XuanqinYu/eegDevice_DTU/README.md

# eegDevice_DTU

Codes contains Python script to use, and codes in Arduino or ESP-IDF for developing.

Design files contains schematic design and PCB design in KiCAD. And the simulation circuit is done in Ti-Tina.

Manual introduces how to use the script to visualize data and develop the device.
