XuanqinYu/eegDevice_DTU/Design Files/[Tina-TI] Simulation circuit/readme.TXT

This the amplification and filtering circuit for 4-channel EEG device. Including
	40 dB IA,
	0.5 Hz LPF,
	70 Hz HPF,
	40 dB amplifier,
	50 Hz Notch filter,
	2/VCC DC offset circuit,
	2 v/v AC amplifier
