XuanqinYu/eegDevice_DTU/Design Files/[KiCAD] EEG_single-channel_device/eeg_diy.kicad_pcb

## KiCad design Design Files/[KiCAD] EEG_single-channel_device/eeg_diy.kicad_pcb (2025-04-14)

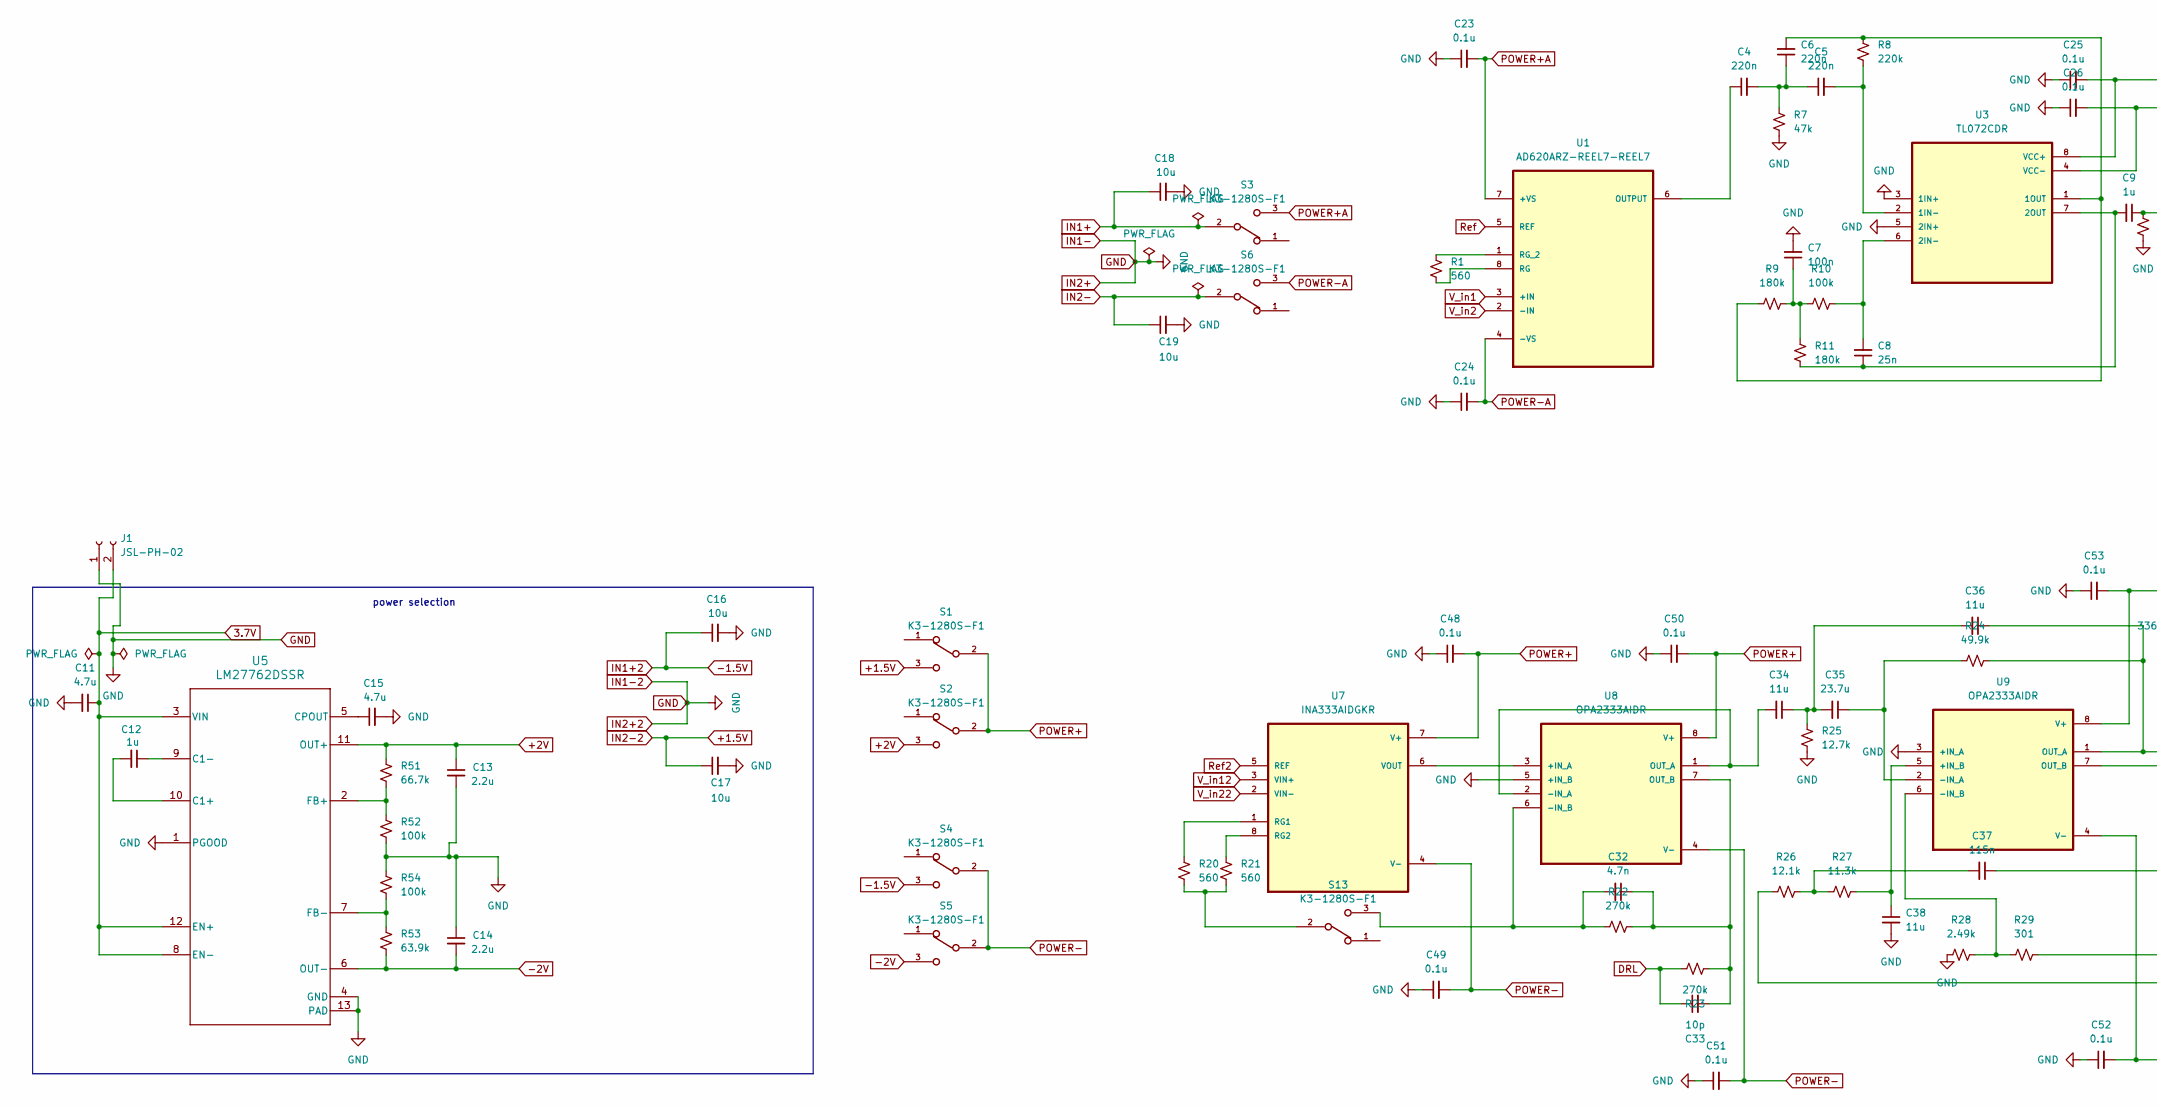
[picture p68: schematic eeg_diy.kicad_sch, part in row 1, column 1]

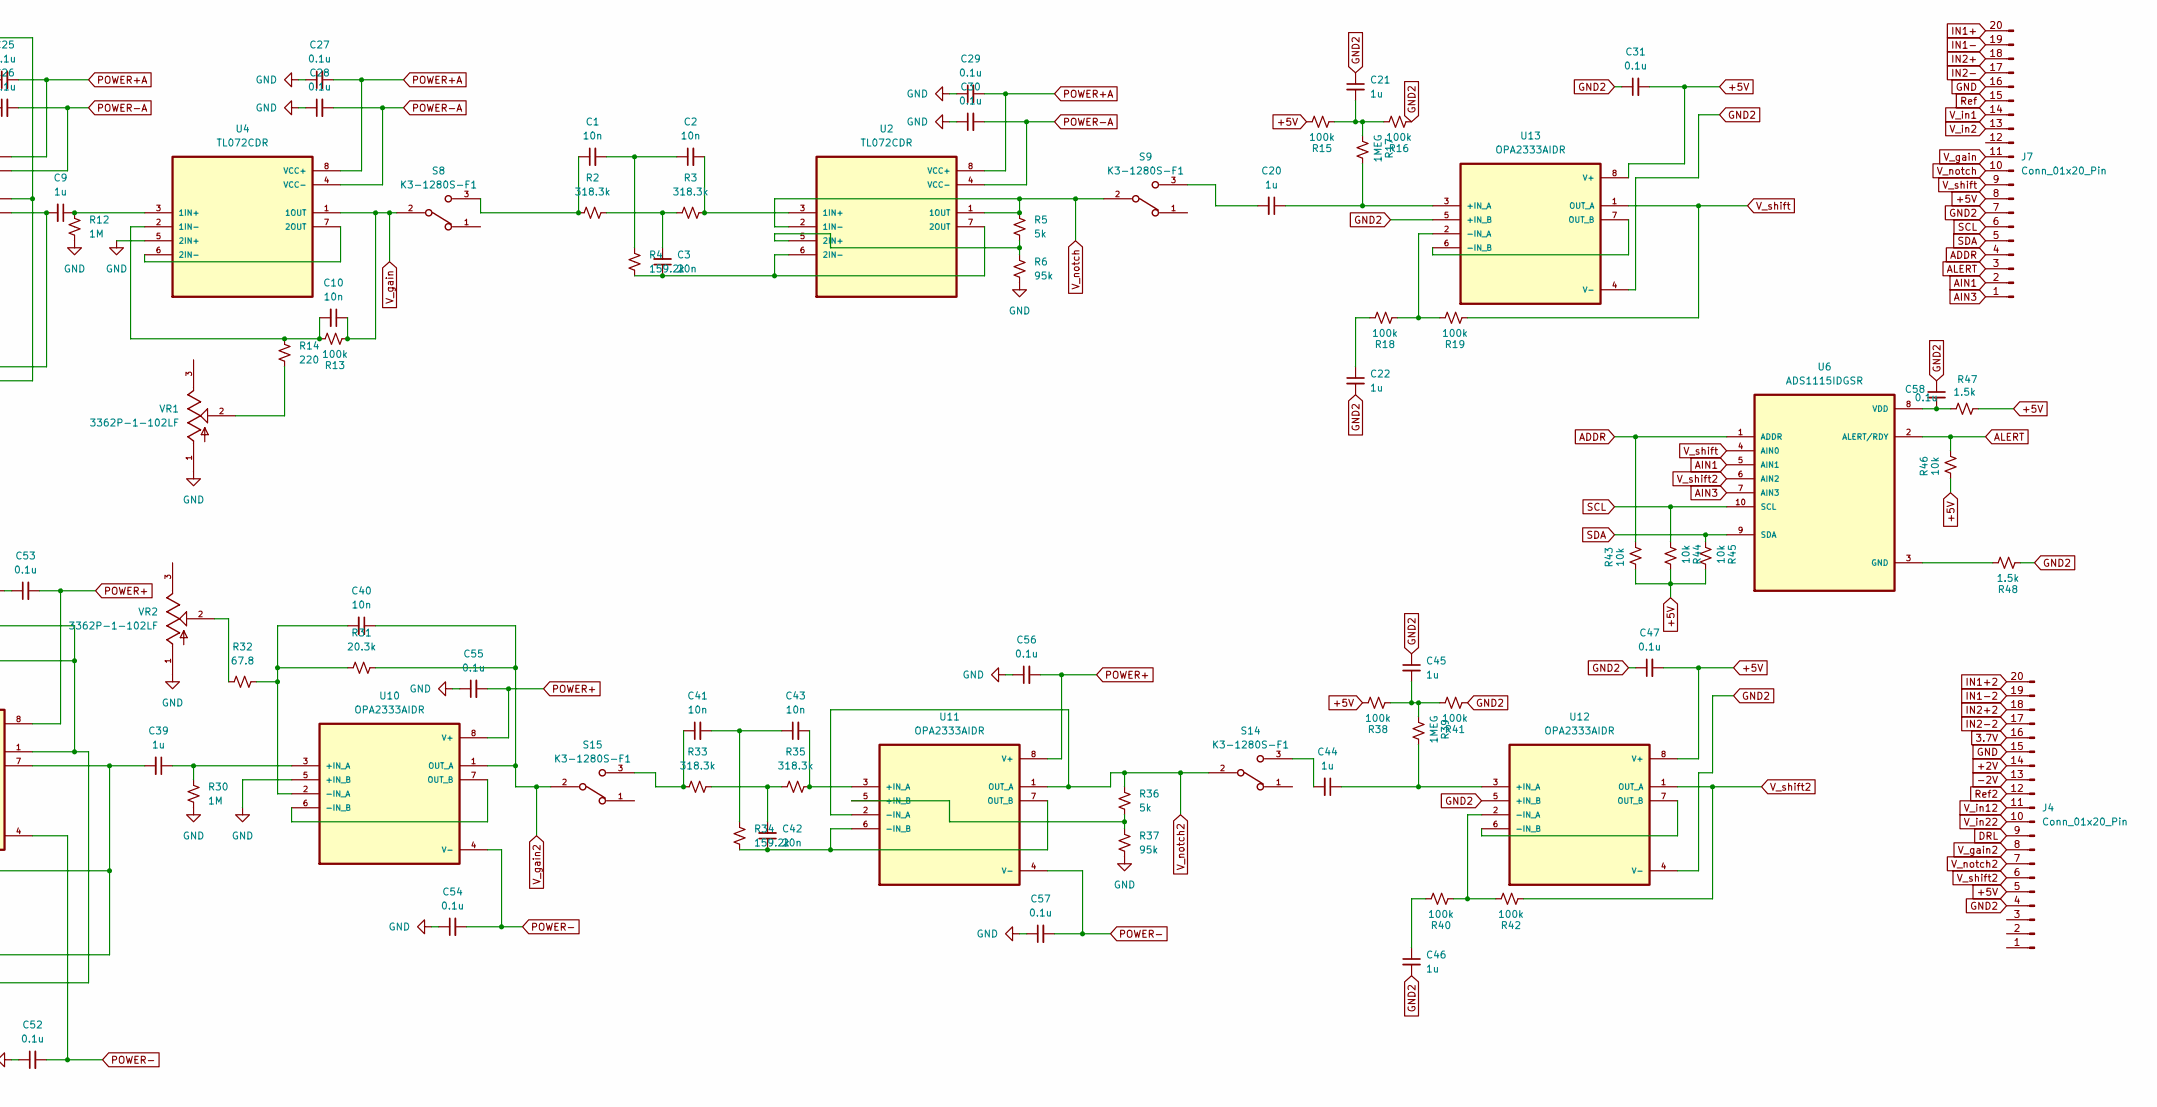
[picture p69: schematic eeg_diy.kicad_sch, part in row 1, column 2]

Parts:
C1, C2, C10, C40, C41, C43: 10n; C_0805_2012Metric
C3, C42: 20n; C_0805_2012Metric
C4, C5, C6: 220n; C_0805_2012Metric
C7: 100n; C_0805_2012Metric
C8: 25n; C_0805_2012Metric
C9, C12, C20, C21, C22, C39, C44, C45, C46: 1u; C_0805_2012Metric
C11, C15: 4.7u; C_0805_2012Metric
C13, C14: 2.2u; C_0603_1608Metric
C16, C17, C18, C19: 10u; C_0805_2012Metric
C23, C24, C25, C26, C27, C28, C29, C30, C31, C47, C48, C49, C50, C51, C52, C53, C54, C55, C56, C57, C58: 0.1u; C_0805_2012Metric
C32: 4.7n; C_0805_2012Metric
C33: 10p; C_0603_1608Metric
C34, C36, C38: 11u; C_0805_2012Metric
C35: 23.7u; C_0805_2012Metric
C37: 115n; C_0805_2012Metric
J1: JSL-PH-02; JST_PH_B2B-PH-K_1x02_P2.00mm_Vertical
J4, J7: Conn_01x20_Pin; PinSocket_1x20_P2.54mm_Vertical
R1, R20, R21: 560; R_0805_2012Metric
R2, R3, R33, R35: 318.3k; R_0603_1608Metric
R4, R34: 159.2k; R_0603_1608Metric
R5, R36: 5k; R_0603_1608Metric
R6, R37: 95k; R_0402_1005Metric
R7: 47k; R_0805_2012Metric
R8: 220k; R_0805_2012Metric
R9, R11: 180k; R_0805_2012Metric
R10, R13, R15, R16, R18, R19, R38, R40, R41, R42, R52, R54: 100k; R_0603_1608Metric
R12, R30: 1M; R_0805_2012Metric
R14: 220; R_0805_2012Metric
R17, R39: 1MEG; R_0805_2012Metric
R22, R23: 270k; R_0805_2012Metric
R24: 49.9k; R_0805_2012Metric
R25: 12.7k; R_0805_2012Metric
R26: 12.1k; R_0805_2012Metric
R27: 11.3k; R_0805_2012Metric
R28: 2.49k; R_0805_2012Metric
R29: 301; R_0805_2012Metric
R31: 20.3k; R_0805_2012Metric
R32: 67.8; R_0805_2012Metric
R43, R44, R45, R46: 10k; R_0805_2012Metric
R47, R48: 1.5k; R_0805_2012Metric
R51: 66.7k; R_0805_2012Metric
R53: 63.9k; R_0603_1608Metric
S1, S2, S3, S4, S5, S6, S8, S9, S13, S14, S15: K3-1280S-F1; SW_JS102011SAQN
U1: AD620ARZ-REEL7-REEL7; SOIC127P599X175-8N; MPN AD620ARZ-REEL7-REEL7
U2, U3, U4: TL072CDR; SOIC127P599X175-8N
U5: LM27762DSSR; DSS0012B
U6: ADS1115IDGSR; SOP50P490X110-10N
U7: INA333AIDGKR; SOP65P490X110-8N
U8, U9, U10, U11, U12, U13: OPA2333AIDR; SOIC127P599X175-8N
VR1, VR2: 3362P-1-102LF; TRIM_3362P-1-102LF; PARTREV 08/26/10

Connections:
3.7V: C11.1, J1.2, J4.16, U5.3 (VIN), U5.8 (EN-), U5.12 (EN+)
+1.5V: C17.1, J4.17, S1.3
+2V: C13.1, J4.14, R51.2, S2.3, U5.11 (OUT+)
+5V: C31.2, C47.2, J4.5, J7.8, R15.1, R38.1, R43.2, R44.1, R45.1, R46.2, R47.2, U12.8 (V+), U13.8 (V+)
-1.5V: C16.1, J4.20, S4.3
-2V: C14.2, J4.13, R53.1, S5.3, U5.6 (OUT-)
ADDR: J7.4, R43.1, U6.1 (ADDR)
AIN1: J7.2, U6.5 (AIN1)
AIN3: J7.1, U6.7 (AIN3)
ALERT: J7.3, R46.1, U6.2 (ALERT/RDY)
DRL: C33.1, J4.9, R23.2
GND: C7.2, C11.2, C13.2, C14.1, C15.2, C16.2, C17.2, C18.2, C19.2, C23.1, C24.1, C25.1, C26.1, C27.1, C28.1, C29.1, C30.1, C38.2, C48.1, C49.1, C50.1, C51.1, C52.1, C53.1, C54.1, C55.1, C56.1, C57.1, J1.1, J4.15, J4.18, J4.19, J7.16, J7.18, J7.19, R6.1, R7.1, R12.2, R25.1, R28.2, R30.2, R37.1, R52.1, R54.2, U3.3 (1IN+), U3.5 (2IN+), U4.5 (2IN+), U5.1 (PGOOD), U5.4 (GND), U5.13 (PAD), U8.5 (+IN_B), U9.3 (+IN_A), U10.5 (+IN_B), VR1.1, VR2.1
GND2: C21.1, C22.2, C31.1, C45.1, C46.2, C47.1, C58.1, J4.4, J7.7, R16.2, R41.2, R48.2, U12.4 (V-), U12.5 (+IN_B), U13.4 (V-), U13.5 (+IN_B)
IN1+: C18.1, J7.20, S3.2
IN2-: C19.1, J7.17, S6.2
unnamed: C1.1, R2.1, S8.3
unnamed: C1.2, C2.1, R4.2
unnamed: C3.2, R2.2, R3.1
unnamed: C4.2, C5.1, C6.1, R7.2
unnamed: C7.1, R9.1, R10.2, R11.1
unnamed: C20.2, S9.3
unnamed: C21.2, R15.2, R16.1, R17.2
unnamed: C22.1, R18.1
unnamed: C34.1, C35.2, C36.2, R25.2
unnamed: C37.2, R26.1, R27.2
unnamed: C41.1, R33.1, S15.3
unnamed: C41.2, C43.1, R34.2
unnamed: C42.2, R33.2, R35.1
unnamed: C44.2, S14.3
unnamed: C45.2, R38.2, R39.2, R41.1
unnamed: C46.1, R40.1
unnamed: R14.2, VR1.2
unnamed: R20.2, R21.2, S13.2
unnamed: R32.1, VR2.2
unnamed: C4.1, U1.6 (OUTPUT)
unnamed: R1.2, U1.8 (RG)
unnamed: R1.1, U1.1 (RG_2)
unnamed: C2.2, R3.2, U2.3 (1IN+)
unnamed: R5.1, R6.2, U2.5 (2IN+)
unnamed: C3.1, R4.1, U2.6 (2IN-), U2.7 (2OUT)
unnamed: C5.2, R8.1, U3.2 (1IN-)
unnamed: C6.2, R8.2, R9.2, U3.1 (1OUT)
unnamed: C8.2, R10.1, U3.6 (2IN-)
unnamed: C8.1, C9.2, R11.2, U3.7 (2OUT)
unnamed: C9.1, R12.1, U4.3 (1IN+)
unnamed: C10.2, R13.1, R14.1, U4.2 (1IN-)
unnamed: U4.6 (2IN-), U4.7 (2OUT)
unnamed: C12.2, U5.10 (C1+)
unnamed: C12.1, U5.9 (C1-)
unnamed: C15.1, U5.5 (CPOUT)
unnamed: R51.1, R52.2, U5.2 (FB+)
unnamed: R53.2, R54.1, U5.7 (FB-)
unnamed: R48.1, U6.3 (GND)
unnamed: C58.2, R47.1, U6.8 (VDD)
unnamed: R20.1, U7.1 (RG1)
unnamed: R21.1, U7.8 (RG2)
unnamed: U7.6 (VOUT), U8.3 (+IN_A)
unnamed: C34.2, U8.1 (OUT_A), U8.2 (-IN_A)
unnamed: C32.2, R22.1, S13.3, U8.6 (-IN_B)
unnamed: C32.1, C33.2, R22.2, R23.1, U8.7 (OUT_B)
unnamed: C38.1, R27.1, U9.5 (+IN_B)
unnamed: C35.1, R24.1, U9.2 (-IN_A)
unnamed: R28.1, R29.2, U9.6 (-IN_B)
unnamed: C36.1, R24.2, R26.2, U9.1 (OUT_A)
unnamed: C37.1, C39.2, R29.1, U9.7 (OUT_B)
unnamed: C39.1, R30.1, U10.3 (+IN_A)
unnamed: C40.2, R31.1, R32.2, U10.2 (-IN_A)
unnamed: U10.6 (-IN_B), U10.7 (OUT_B)
unnamed: C43.2, R35.2, U11.3 (+IN_A)
unnamed: R36.1, R37.2, U11.5 (+IN_B)
unnamed: C42.1, R34.1, U11.6 (-IN_B), U11.7 (OUT_B)
unnamed: C44.1, R39.1, U12.3 (+IN_A)
unnamed: R40.2, R42.1, U12.2 (-IN_A)
unnamed: U12.6 (-IN_B), U12.7 (OUT_B)
unnamed: C20.1, R17.1, U13.3 (+IN_A)
unnamed: R18.2, R19.1, U13.2 (-IN_A)
unnamed: U13.6 (-IN_B), U13.7 (OUT_B)
POWER+: C48.2, C50.2, C53.2, C55.2, C56.2, S1.2, S2.2, U7.7 (V+), U8.8 (V+), U9.8 (V+), U10.8 (V+), U11.8 (V+)
POWER+A: C23.2, C25.2, C27.2, C29.2, S3.3, U1.7 (+VS), U2.8 (VCC+), U3.8 (VCC+), U4.8 (VCC+)
POWER-: C49.2, C51.2, C52.2, C54.2, C57.2, S4.2, S5.2, U7.4 (V-), U8.4 (V-), U9.4 (V-), U10.4 (V-), U11.4 (V-)
POWER-A: C24.2, C26.2, C28.2, C30.2, S6.3, U1.4 (-VS), U2.4 (VCC-), U3.4 (VCC-), U4.4 (VCC-)
Ref: J7.15, U1.5 (REF)
Ref2: J4.12, U7.5 (REF)
SCL: J7.6, R44.2, U6.10 (SCL)
SDA: J7.5, R45.2, U6.9 (SDA)
V_gain: C10.1, J7.11, R13.2, S8.2, U4.1 (1OUT)
V_gain2: C40.1, J4.8, R31.2, S15.2, U10.1 (OUT_A)
V_in1: J7.14, U1.3 (+IN)
V_in2: J7.13, U1.2 (-IN)
V_in12: J4.11, U7.3 (VIN+)
V_in22: J4.10, U7.2 (VIN-)
V_notch: J7.10, R5.2, S9.2, U2.1 (1OUT), U2.2 (1IN-)
V_notch2: J4.7, R36.2, S14.2, U11.1 (OUT_A), U11.2 (-IN_A)
V_shift: J7.9, R19.2, U6.4 (AIN0), U13.1 (OUT_A)
V_shift2: J4.6, R42.2, U6.6 (AIN2), U12.1 (OUT_A)

Notes on the sheet:
power selection

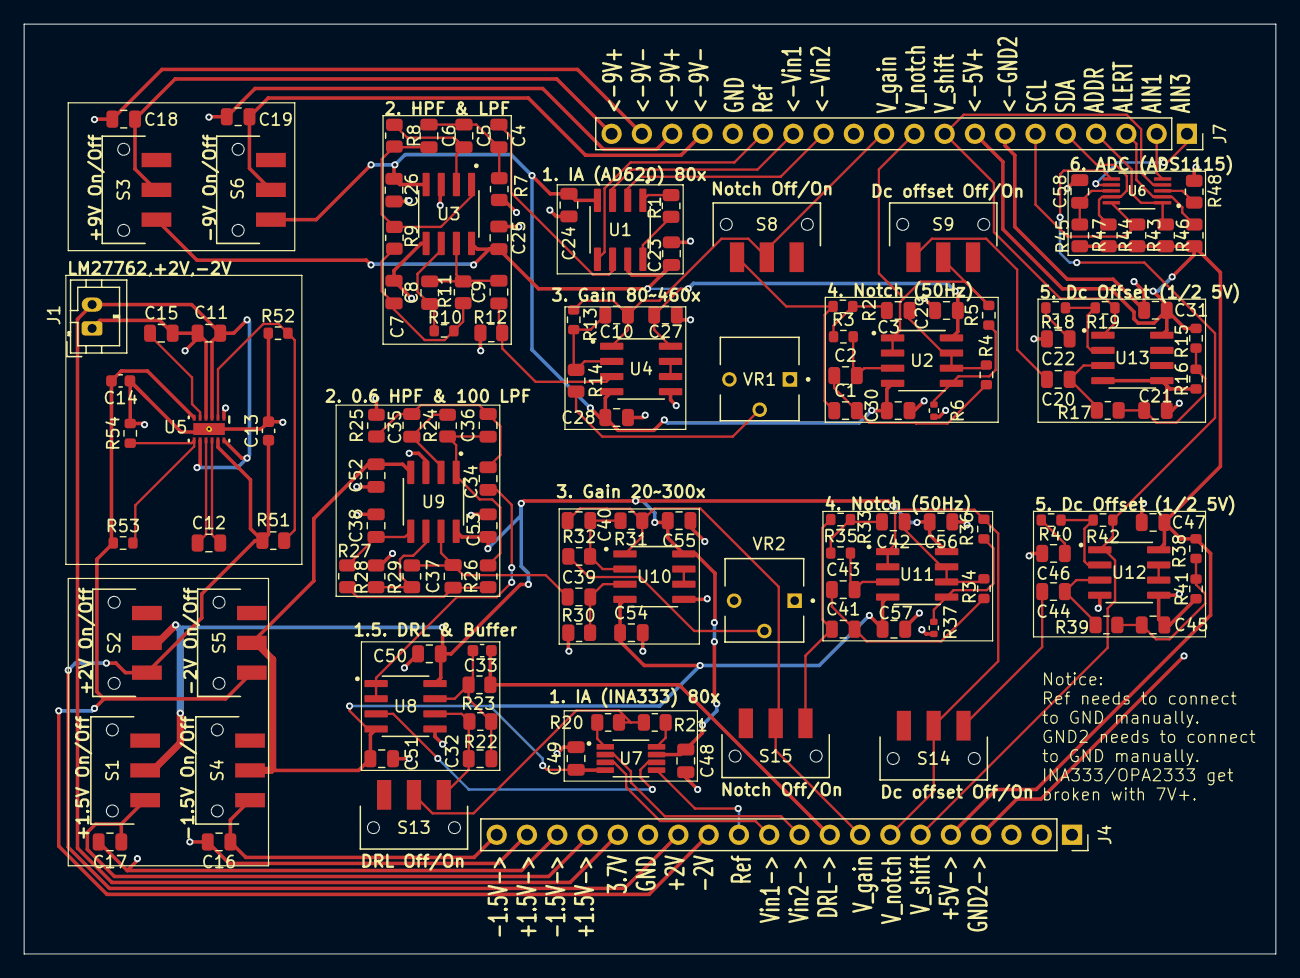
[picture p70: board eeg_diy.kicad_pcb from above]

Board: 2 copper layers, 105.0 x 78.0 mm, 139 parts (0 on the bottom side), 95 nets.
