XuanqinYu/eegDevice_DTU/Design Files/[KiCAD] EEG_4-channel_device/eeg_4-channel_final.kicad_pcb

## KiCad design Design Files/[KiCAD] EEG_4-channel_device/eeg_4-channel_final.kicad_pcb (2025-03-30)

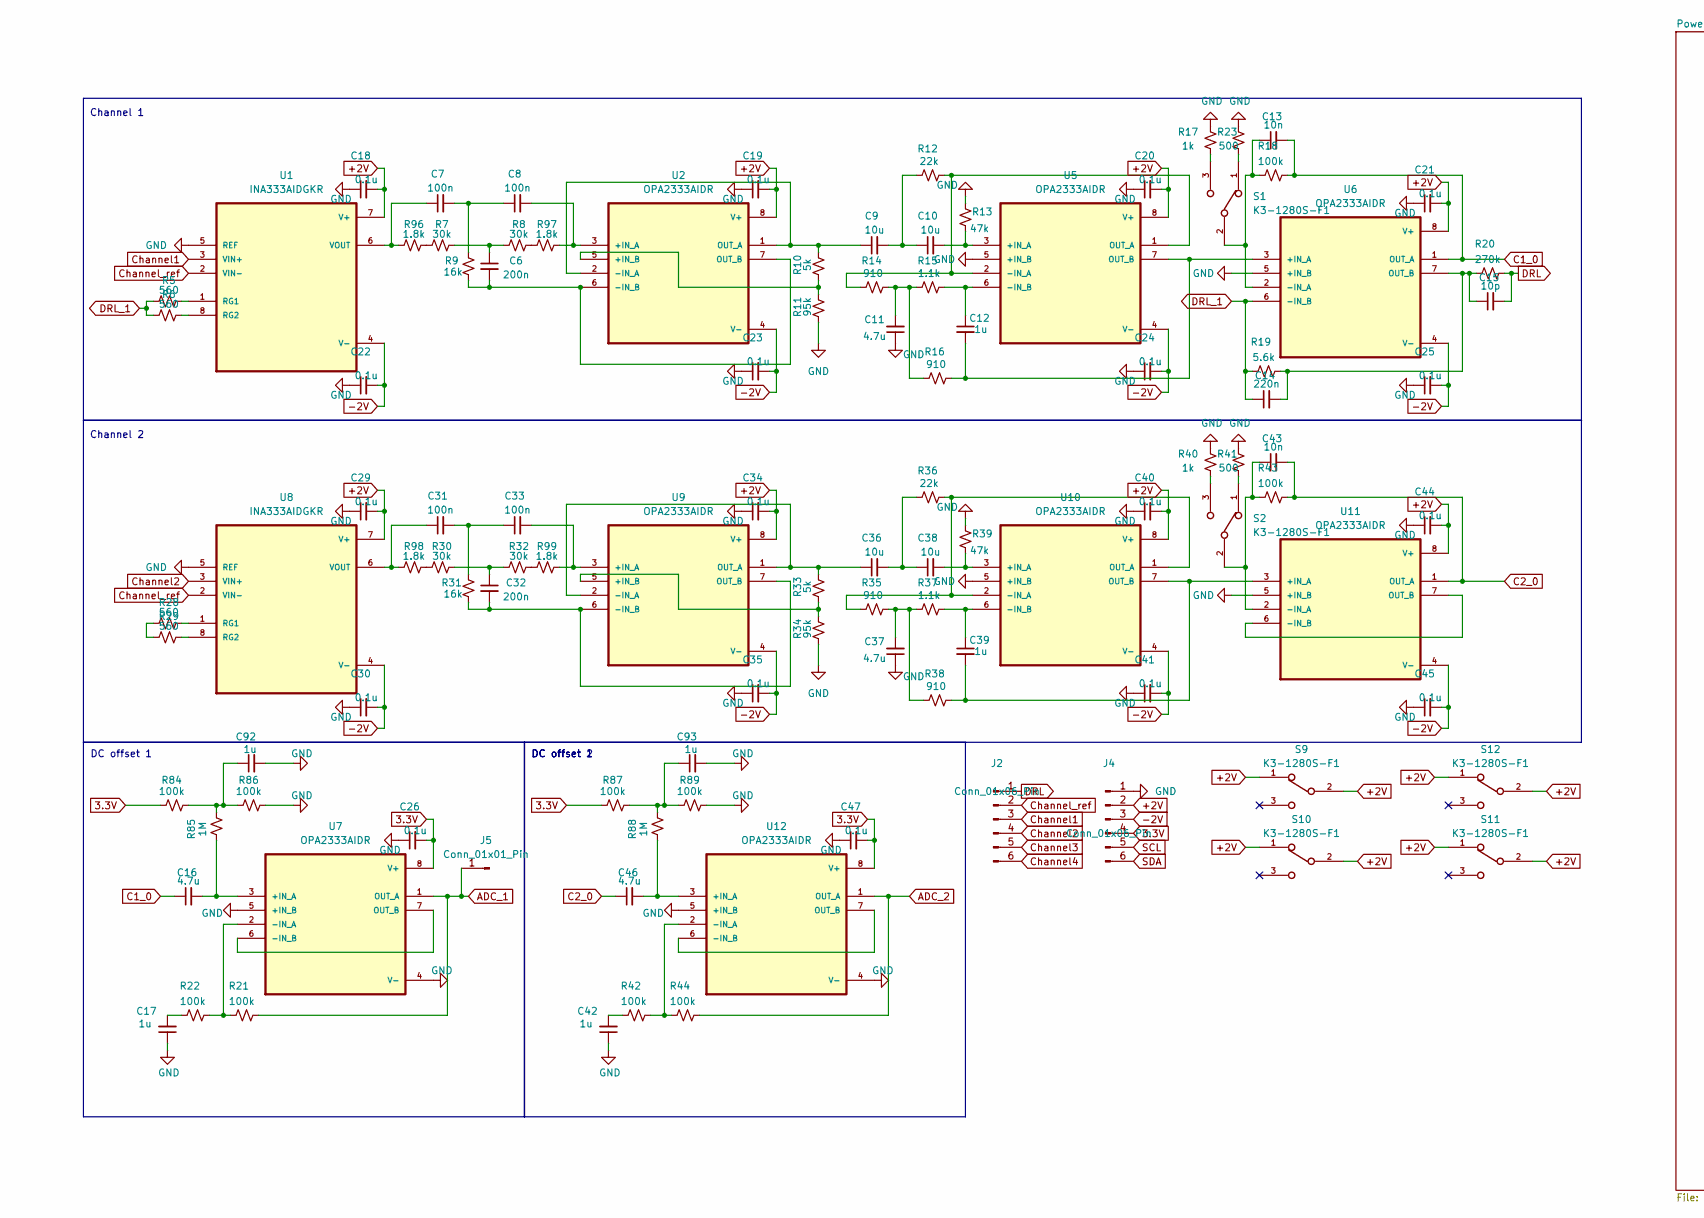
[picture p71: schematic eeg_4-channel_final.kicad_sch, part in row 1, column 1]

Parts:
C6, C32: 200n; C_0805_2012Metric
C7, C8, C31, C33: 100n; C_0805_2012Metric
C9, C10, C36, C38: 10u; C_0805_2012Metric
C11, C16, C37, C46: 4.7u; C_0805_2012Metric
C12, C17, C39, C42, C92, C93: 1u; C_0805_2012Metric
C13, C43: 10n; C_0805_2012Metric
C14: 220n; C_0805_2012Metric
C15: 10p; C_0603_1608Metric
C18, C19, C20, C21, C22, C23, C24, C25, C26, C29, C30, C34, C35, C40, C41, C44, C45, C47: 0.1u; C_0805_2012Metric
J2, J4: Conn_01x06_Pin; PinHeader_1x06_P2.54mm_Vertical
J5: Conn_01x01_Pin; PinHeader_1x01_P2.54mm_Vertical
R5, R6, R28, R29: 560; R_0805_2012Metric
R7, R8, R30, R32: 30k; R_0805_2012Metric
R9, R31: 16k; R_0805_2012Metric
R10, R33: 5k; R_0805_2012Metric
R11, R34: 95k; R_0603_1608Metric
R12, R36: 22k; R_0805_2012Metric
R13, R39: 47k; R_0805_2012Metric
R14, R16, R35, R38: 910; R_0805_2012Metric
R15, R37: 1.1k; R_0603_1608Metric
R17, R40: 1k; R_0805_2012Metric
R18, R21, R22, R42, R43, R44, R84, R86, R87, R89: 100k; R_0603_1608Metric
R19: 5.6k; R_0805_2012Metric
R20: 270k; R_0805_2012Metric
R23, R41: 500; R_0805_2012Metric
R85, R88: 1M; R_0805_2012Metric
R96, R97, R98, R99: 1.8k; R_0805_2012Metric
S1, S2, S9, S10, S11, S12: K3-1280S-F1; SW_JS102011SAQN
U1, U8: INA333AIDGKR; SOP65P490X110-8N
U2, U5, U6, U7, U9, U10, U11, U12: OPA2333AIDR; SOIC127P599X175-8N

Connections:
3.3V: C26.2, C47.2, J4.4, R84.1, R87.1, U7.8 (V+), U12.8 (V+); also elsewhere on the board
+2V: C18.2, C19.2, C20.2, C21.2, C29.2, C34.2, C40.2, C44.2, J4.2, S9.1, S9.2, S10.1, S10.2, S11.1, S11.2, S12.1, S12.2, U1.7 (V+), U2.8 (V+), U5.8 (V+), U6.8 (V+), U8.7 (V+), U9.8 (V+), U10.8 (V+), U11.8 (V+); also elsewhere on the board
-2V: C22.2, C23.2, C24.2, C25.2, C30.2, C35.2, C41.2, C45.2, J4.3, U1.4 (V-), U2.4 (V-), U5.4 (V-), U6.4 (V-), U8.4 (V-), U9.4 (V-), U10.4 (V-), U11.4 (V-); also elsewhere on the board
ADC_1: J5.1, R21.2, U7.1 (OUT_A); also elsewhere on the board
ADC_2: R44.2, U12.1 (OUT_A); also elsewhere on the board
C1_0: C13.2, C16.1, R18.2, U6.1 (OUT_A)
C2_0: C43.2, C46.1, R43.2, U11.1 (OUT_A)
Channel1: J2.3, U1.3 (VIN+)
Channel2: J2.4, U8.3 (VIN+)
Channel3: J2.5; also elsewhere on the board
Channel4: J2.6; also elsewhere on the board
Channel_ref: J2.2, U1.2 (VIN-), U8.2 (VIN-); also elsewhere on the board
DRL: C15.2, J2.1, R20.2
DRL_1: C14.1, R5.2, R6.2, R19.1, U6.6 (-IN_B)
GND: C11.1, C17.1, C18.1, C19.1, C20.1, C21.1, C22.1, C23.1, C24.1, C25.1, C26.1, C29.1, C30.1, C34.1, C35.1, C37.1, C40.1, C41.1, C42.1, C44.1, C45.1, C47.1, C92.2, C93.2, J4.1, R11.2, R13.1, R17.1, R23.2, R34.2, R39.1, R40.1, R41.2, R86.2, R89.2, U1.5 (REF), U5.5 (+IN_B), U6.5 (+IN_B), U7.4 (V-), U7.5 (+IN_B), U8.5 (REF), U10.5 (+IN_B), U11.5 (+IN_B), U12.4 (V-), U12.5 (+IN_B); also elsewhere on the board
unnamed: C6.1, R7.1, R8.2
unnamed: C7.2, C8.1, R9.1
unnamed: C9.2, C10.1, R12.1
unnamed: C11.2, R14.2, R15.1, R16.1
unnamed: C17.2, R22.1
unnamed: C31.2, C33.1, R31.1
unnamed: C32.1, R30.1, R32.2
unnamed: C36.2, C38.1, R36.1
unnamed: C37.2, R35.2, R37.1, R38.1
unnamed: C42.2, R42.1
unnamed: C92.1, R84.2, R85.2, R86.1
unnamed: C93.1, R87.2, R88.2, R89.1
unnamed: R7.2, R96.1
unnamed: R8.1, R97.2
unnamed: R17.2, S1.3
unnamed: R23.1, S1.1
unnamed: R28.2, R29.2
unnamed: R30.2, R98.1
unnamed: R32.1, R99.2
unnamed: R40.2, S2.3
unnamed: R41.1, S2.1
unnamed: R5.1, U1.1 (RG1)
unnamed: R6.1, U1.8 (RG2)
unnamed: C7.1, R96.2, U1.6 (VOUT)
unnamed: C8.2, R97.1, U2.3 (+IN_A)
unnamed: R10.2, R11.1, U2.5 (+IN_B)
unnamed: C9.1, R10.1, U2.1 (OUT_A), U2.2 (-IN_A)
unnamed: C6.2, R9.2, U2.6 (-IN_B), U2.7 (OUT_B)
unnamed: C10.2, R13.2, U5.3 (+IN_A)
unnamed: R12.2, R14.1, U5.1 (OUT_A), U5.2 (-IN_A)
unnamed: C12.1, R15.2, U5.6 (-IN_B)
unnamed: C12.2, R16.2, U5.7 (OUT_B), U6.3 (+IN_A)
unnamed: C13.1, R18.1, S1.2, U6.2 (-IN_A)
unnamed: C14.2, C15.1, R19.2, R20.1, U6.7 (OUT_B)
unnamed: C16.2, R85.1, U7.3 (+IN_A)
unnamed: R21.1, R22.2, U7.2 (-IN_A)
unnamed: U7.6 (-IN_B), U7.7 (OUT_B)
unnamed: R28.1, U8.1 (RG1)
unnamed: R29.1, U8.8 (RG2)
unnamed: C31.1, R98.2, U8.6 (VOUT)
unnamed: C33.2, R99.1, U9.3 (+IN_A)
unnamed: R33.2, R34.1, U9.5 (+IN_B)
unnamed: C36.1, R33.1, U9.1 (OUT_A), U9.2 (-IN_A)
unnamed: C32.2, R31.2, U9.6 (-IN_B), U9.7 (OUT_B)
unnamed: C38.2, R39.2, U10.3 (+IN_A)
unnamed: R35.1, R36.2, U10.1 (OUT_A), U10.2 (-IN_A)
unnamed: C39.1, R37.2, U10.6 (-IN_B)
unnamed: C39.2, R38.2, U10.7 (OUT_B), U11.3 (+IN_A)
unnamed: C43.1, R43.1, S2.2, U11.2 (-IN_A)
unnamed: U11.6 (-IN_B), U11.7 (OUT_B)
unnamed: C46.2, R88.1, U12.3 (+IN_A)
unnamed: R42.2, R44.1, U12.2 (-IN_A)
unnamed: U12.6 (-IN_B), U12.7 (OUT_B)
SCL: J4.5; also elsewhere on the board
SDA: J4.6; also elsewhere on the board

Notes on the sheet:
Channel 1
DC offset 2
DC offset 1
Channel 2

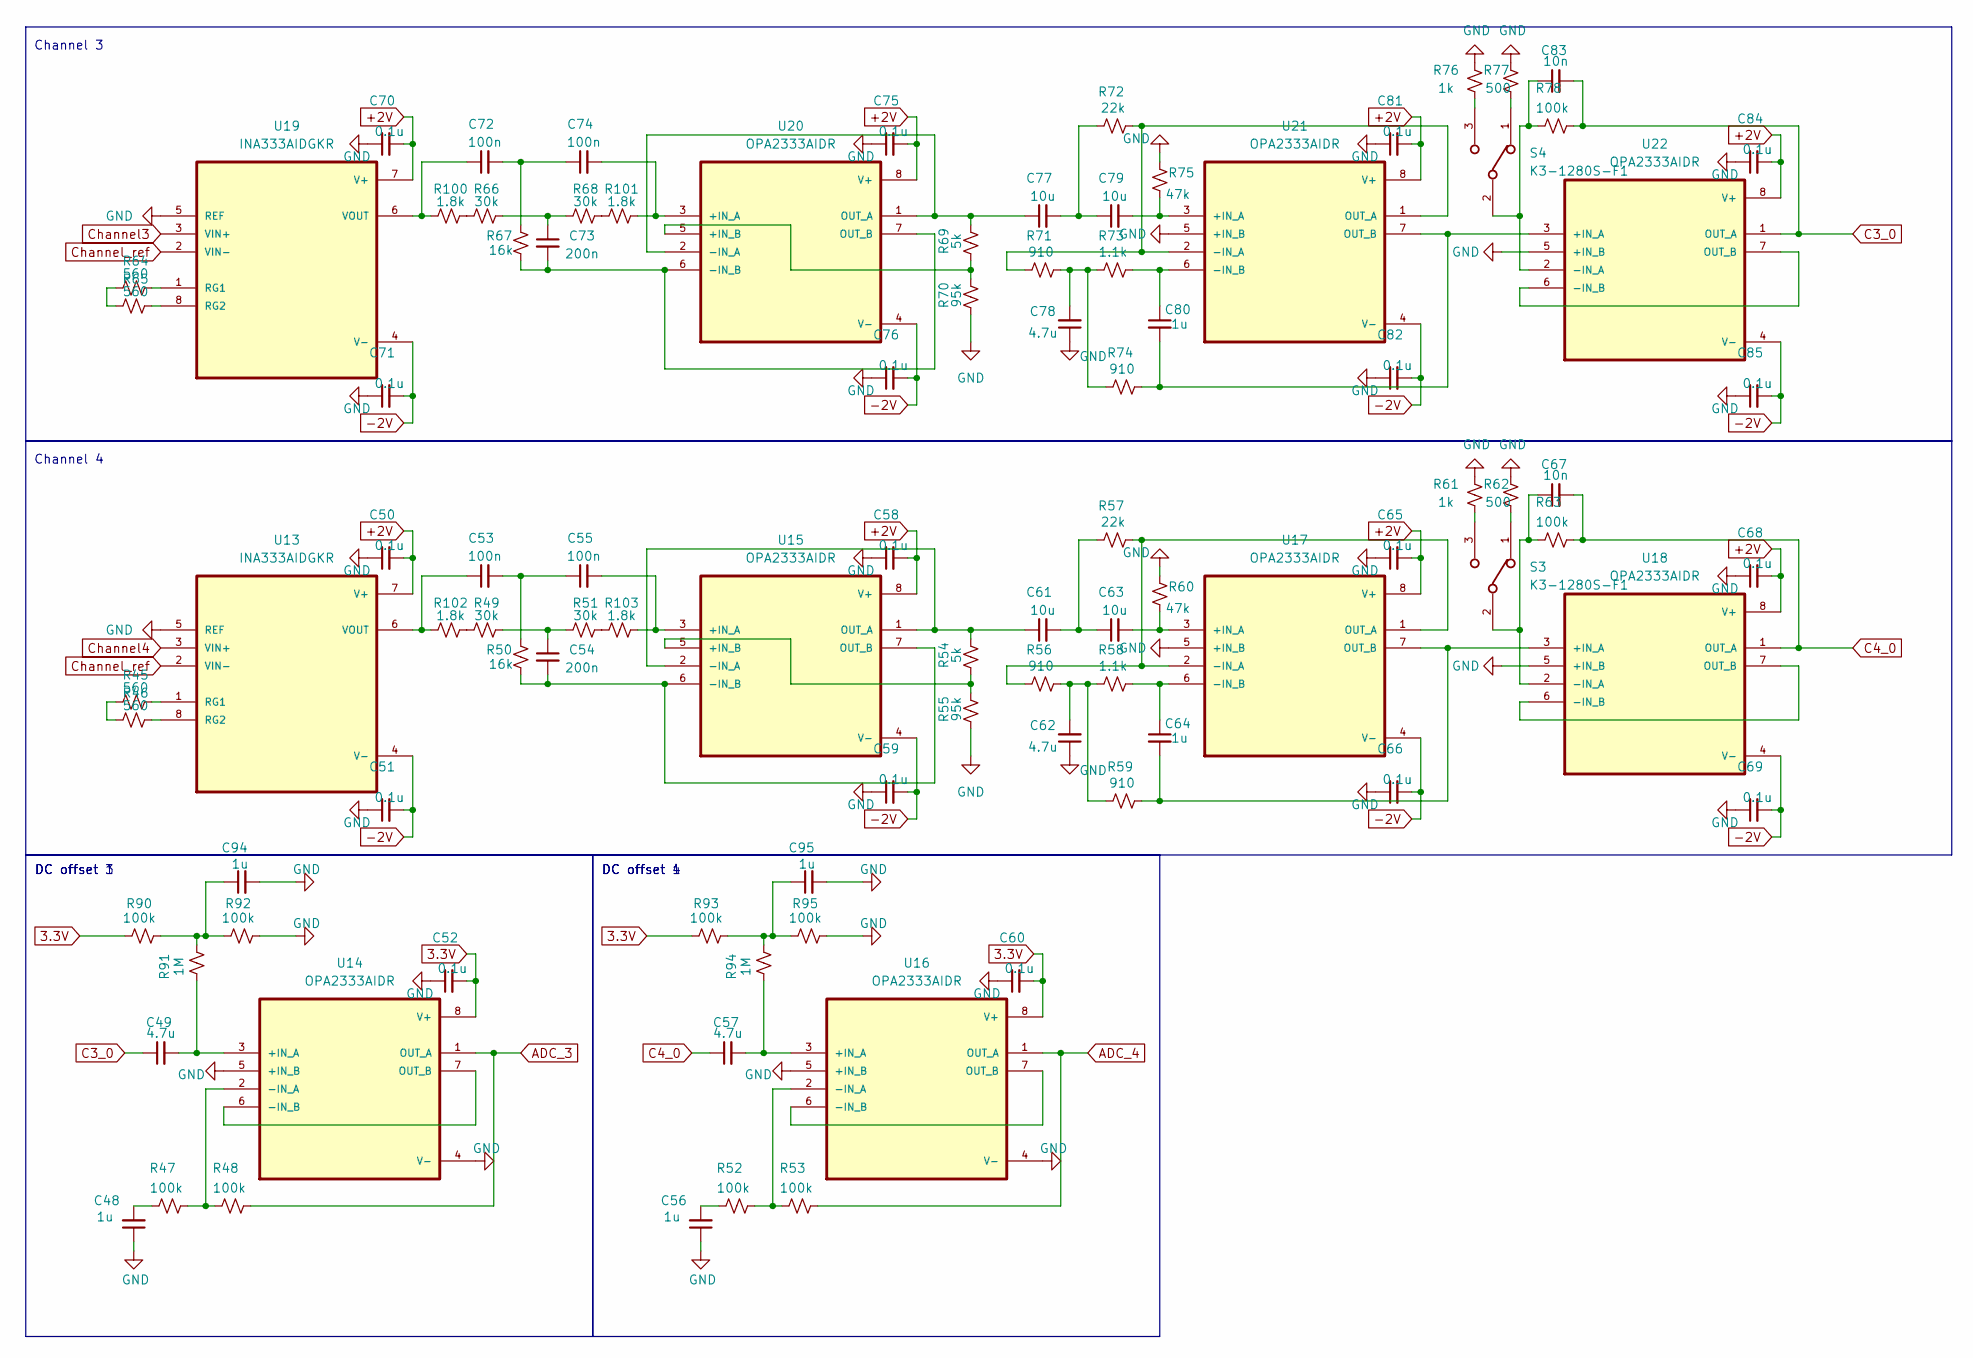
[picture p72: schematic Channel3_4.kicad_sch]

Parts:
C48, C56, C64, C80, C94, C95: 1u; C_0805_2012Metric
C49, C57, C62, C78: 4.7u; C_0805_2012Metric
C50, C51, C52, C58, C59, C60, C65, C66, C68, C69, C70, C71, C75, C76, C81, C82, C84, C85: 0.1u; C_0805_2012Metric
C53, C55, C72, C74: 100n; C_0805_2012Metric
C54, C73: 200n; C_0805_2012Metric
C61, C63, C77, C79: 10u; C_0805_2012Metric
C67, C83: 10n; C_0805_2012Metric
R45, R46, R64, R65: 560; R_0805_2012Metric
R47, R48, R52, R53, R63, R78, R90, R92, R93, R95: 100k; R_0603_1608Metric
R49, R51, R66, R68: 30k; R_0805_2012Metric
R50, R67: 16k; R_0805_2012Metric
R54, R69: 5k; R_0805_2012Metric
R55, R70: 95k; R_0603_1608Metric
R56, R59, R71, R74: 910; R_0805_2012Metric
R57, R72: 22k; R_0805_2012Metric
R58, R73: 1.1k; R_0603_1608Metric
R60, R75: 47k; R_0805_2012Metric
R61, R76: 1k; R_0805_2012Metric
R62, R77: 500; R_0805_2012Metric
R91, R94: 1M; R_0805_2012Metric
R100, R101, R102, R103: 1.8k; R_0805_2012Metric
S3, S4: K3-1280S-F1; SW_JS102011SAQN
U13, U19: INA333AIDGKR; SOP65P490X110-8N
U14, U15, U16, U17, U18, U20, U21, U22: OPA2333AIDR; SOIC127P599X175-8N

Connections:
3.3V: C52.2, C60.2, R90.1, R93.1, U14.8 (V+), U16.8 (V+); also elsewhere on the board
+2V: C50.2, C58.2, C65.2, C68.2, C70.2, C75.2, C81.2, C84.2, U13.7 (V+), U15.8 (V+), U17.8 (V+), U18.8 (V+), U19.7 (V+), U20.8 (V+), U21.8 (V+), U22.8 (V+); also elsewhere on the board
-2V: C51.2, C59.2, C66.2, C69.2, C71.2, C76.2, C82.2, C85.2, U13.4 (V-), U15.4 (V-), U17.4 (V-), U18.4 (V-), U19.4 (V-), U20.4 (V-), U21.4 (V-), U22.4 (V-); also elsewhere on the board
ADC_3: R48.2, U14.1 (OUT_A); also elsewhere on the board
ADC_4: R53.2, U16.1 (OUT_A); also elsewhere on the board
C3_0: C49.1, C83.2, R78.2, U22.1 (OUT_A)
C4_0: C57.1, C67.2, R63.2, U18.1 (OUT_A)
Channel3: U19.3 (VIN+); also elsewhere on the board
Channel4: U13.3 (VIN+); also elsewhere on the board
Channel_ref: U13.2 (VIN-), U19.2 (VIN-); also elsewhere on the board
GND: C48.1, C50.1, C51.1, C52.1, C56.1, C58.1, C59.1, C60.1, C62.1, C65.1, C66.1, C68.1, C69.1, C70.1, C71.1, C75.1, C76.1, C78.1, C81.1, C82.1, C84.1, C85.1, C94.2, C95.2, R55.2, R60.1, R61.1, R62.2, R70.2, R75.1, R76.1, R77.2, R92.2, R95.2, U13.5 (REF), U14.4 (V-), U14.5 (+IN_B), U16.4 (V-), U16.5 (+IN_B), U17.5 (+IN_B), U18.5 (+IN_B), U19.5 (REF), U21.5 (+IN_B), U22.5 (+IN_B); also elsewhere on the board
unnamed: C48.2, R47.1
unnamed: C53.2, C55.1, R50.1
unnamed: C54.1, R49.1, R51.2
unnamed: C56.2, R52.1
unnamed: C61.2, C63.1, R57.1
unnamed: C62.2, R56.2, R58.1, R59.1
unnamed: C72.2, C74.1, R67.1
unnamed: C73.1, R66.1, R68.2
unnamed: C77.2, C79.1, R72.1
unnamed: C78.2, R71.2, R73.1, R74.1
unnamed: C94.1, R90.2, R91.2, R92.1
unnamed: C95.1, R93.2, R94.2, R95.1
unnamed: R45.2, R46.2
unnamed: R61.2, S3.3
unnamed: R62.1, S3.1
unnamed: R64.2, R65.2
unnamed: R76.2, S4.3
unnamed: R77.1, S4.1
unnamed: R66.2, R100.1
unnamed: R68.1, R101.2
unnamed: R49.2, R102.1
unnamed: R51.1, R103.2
unnamed: R45.1, U13.1 (RG1)
unnamed: R46.1, U13.8 (RG2)
unnamed: C53.1, R102.2, U13.6 (VOUT)
unnamed: C49.2, R91.1, U14.3 (+IN_A)
unnamed: R47.2, R48.1, U14.2 (-IN_A)
unnamed: U14.6 (-IN_B), U14.7 (OUT_B)
unnamed: C55.2, R103.1, U15.3 (+IN_A)
unnamed: R54.2, R55.1, U15.5 (+IN_B)
unnamed: C61.1, R54.1, U15.1 (OUT_A), U15.2 (-IN_A)
unnamed: C54.2, R50.2, U15.6 (-IN_B), U15.7 (OUT_B)
unnamed: C57.2, R94.1, U16.3 (+IN_A)
unnamed: R52.2, R53.1, U16.2 (-IN_A)
unnamed: U16.6 (-IN_B), U16.7 (OUT_B)
unnamed: C63.2, R60.2, U17.3 (+IN_A)
unnamed: R56.1, R57.2, U17.1 (OUT_A), U17.2 (-IN_A)
unnamed: C64.1, R58.2, U17.6 (-IN_B)
unnamed: C64.2, R59.2, U17.7 (OUT_B), U18.3 (+IN_A)
unnamed: C67.1, R63.1, S3.2, U18.2 (-IN_A)
unnamed: U18.6 (-IN_B), U18.7 (OUT_B)
unnamed: R64.1, U19.1 (RG1)
unnamed: R65.1, U19.8 (RG2)
unnamed: C72.1, R100.2, U19.6 (VOUT)
unnamed: C74.2, R101.1, U20.3 (+IN_A)
unnamed: R69.2, R70.1, U20.5 (+IN_B)
unnamed: C77.1, R69.1, U20.1 (OUT_A), U20.2 (-IN_A)
unnamed: C73.2, R67.2, U20.6 (-IN_B), U20.7 (OUT_B)
unnamed: C79.2, R75.2, U21.3 (+IN_A)
unnamed: R71.1, R72.2, U21.1 (OUT_A), U21.2 (-IN_A)
unnamed: C80.1, R73.2, U21.6 (-IN_B)
unnamed: C80.2, R74.2, U21.7 (OUT_B), U22.3 (+IN_A)
unnamed: C83.1, R78.1, S4.2, U22.2 (-IN_A)
unnamed: U22.6 (-IN_B), U22.7 (OUT_B)

Notes on the sheet:
DC offset 3
DC offset 4
DC offset 1
Channel 3
Channel 4
