XuanqinYu/eegDevice_DTU/Design Files/[KiCAD] EEG_4-channel_device/eeg_4-channel_final.kicad_pcb

## KiCad design Design Files/[KiCAD] EEG_4-channel_device/eeg_4-channel_final.kicad_pcb (continued)

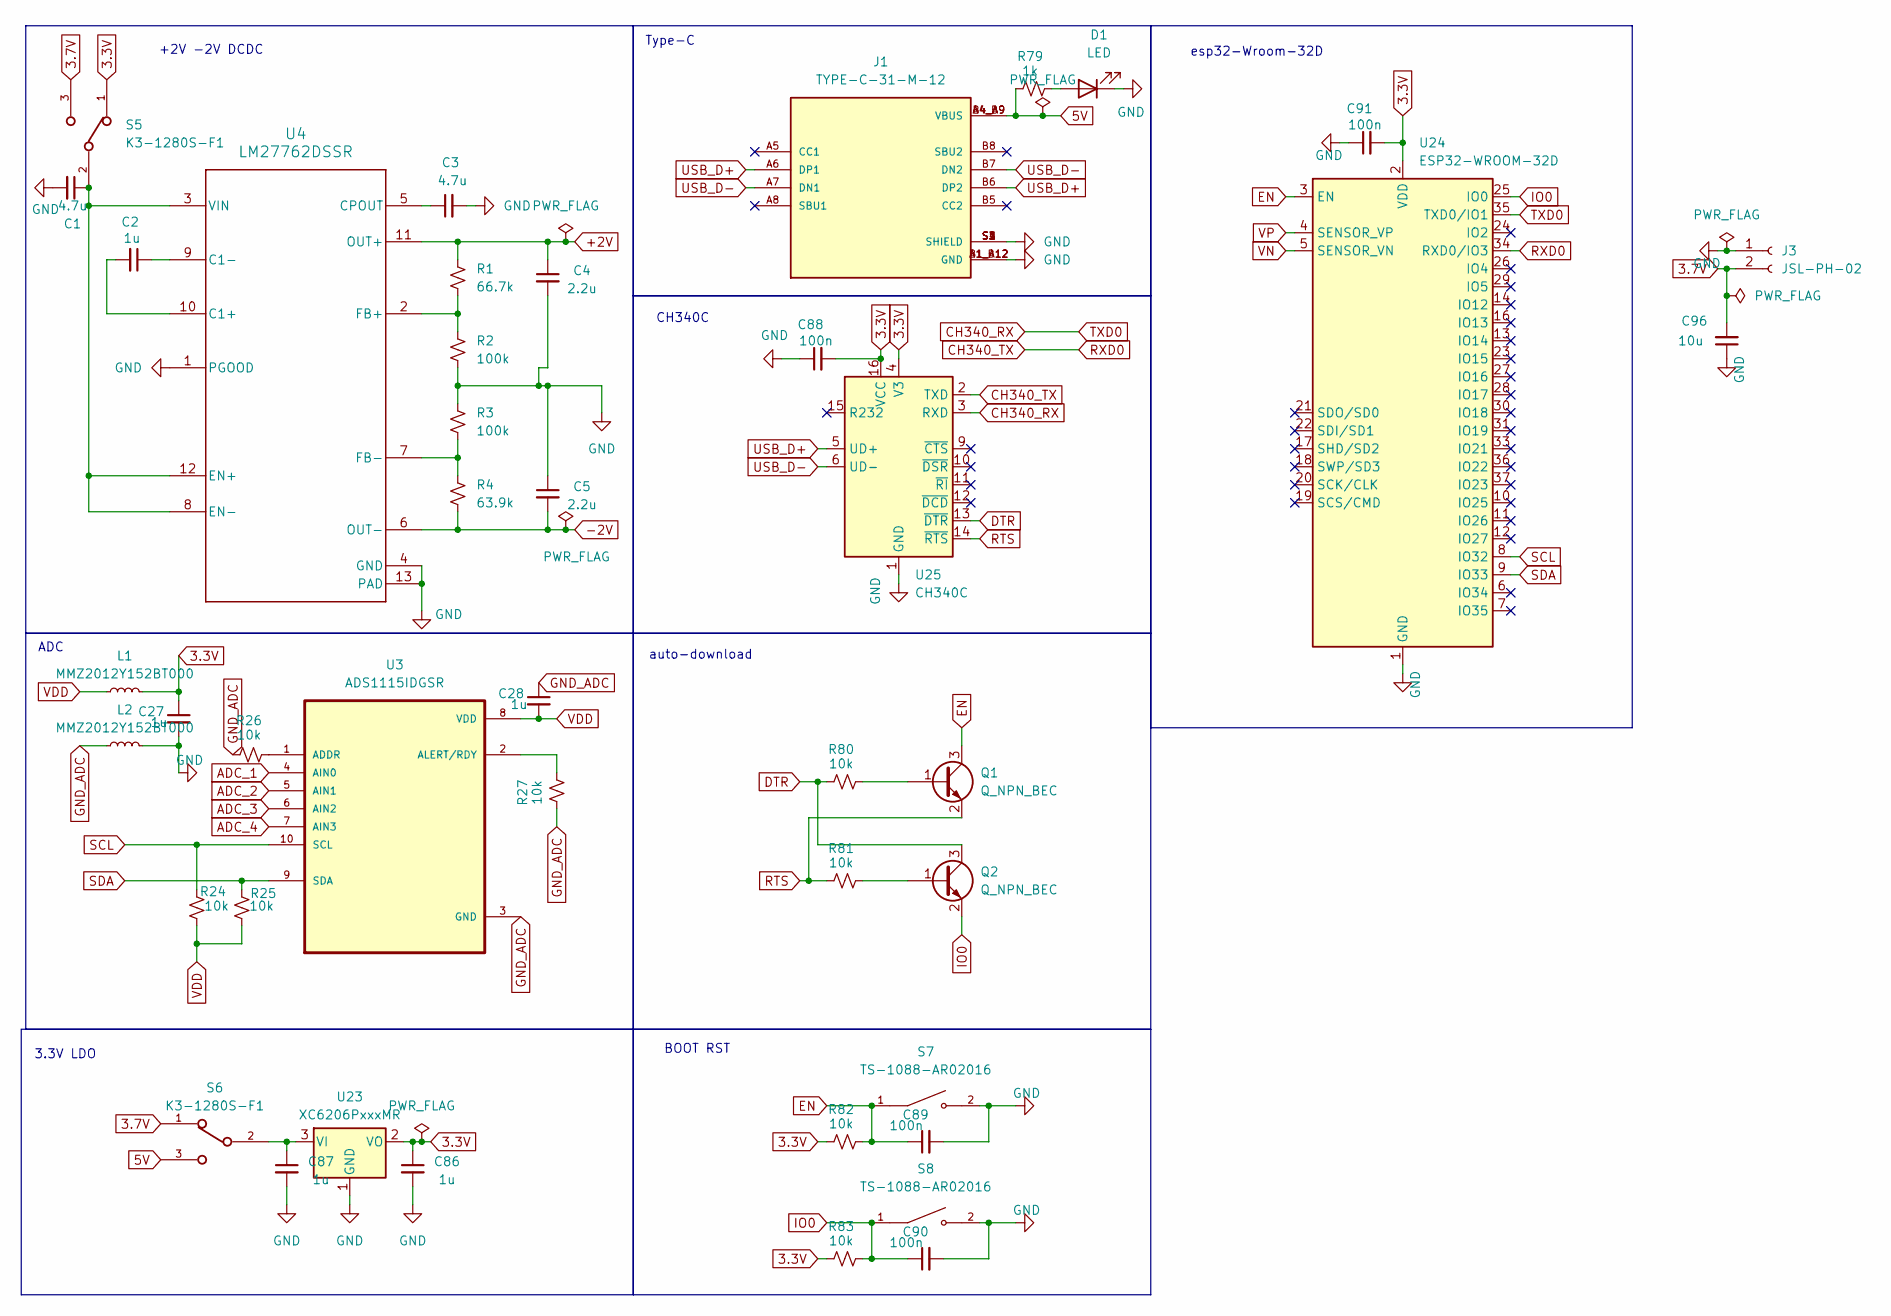
[picture p73: schematic Power_MCU_ADC.kicad_sch]

Parts:
C1, C3: 4.7u; C_0805_2012Metric
C2, C27, C28, C86, C87: 1u; C_0805_2012Metric
C4, C5: 2.2u; C_0603_1608Metric
C88, C89, C90, C91: 100n; C_0805_2012Metric
C96: 10u; C_0805_2012Metric
D1: LED; LED_0805_2012Metric
J1: TYPE-C-31-M-12; HRO_TYPE-C-31-M-12; PARTREV 2020.12.08
J3: JSL-PH-02; JST_PH_B2B-PH-K_1x02_P2.00mm_Vertical
L1, L2: MMZ2012Y152BT000; L_0805_2012Metric
Q1, Q2: Q_NPN_BEC; SOT-23
R1: 66.7k; R_0805_2012Metric
R2, R3: 100k; R_0603_1608Metric
R4: 63.9k; R_0805_2012Metric
R24, R25, R26, R27, R80, R81, R82, R83: 10k; R_0805_2012Metric
R79: 1k; R_0805_2012Metric
S5, S6: K3-1280S-F1; SW_JS102011SAQN
S7, S8: TS-1088-AR02016; SW_TS-1088-AR02016; PARTREV N/A
U3: ADS1115IDGSR; SOP50P490X110-10N
U4: LM27762DSSR; DSS0012B
U23: XC6206PxxxMR; SOT-23-3
U24: ESP32-WROOM-32D
U25: CH340C; SOIC-16_3.9x9.9mm_P1.27mm

Connections:
3.3V: C27.1, C86.1, C88.2, C91.2, L1.2, R82.1, R83.1, S5.1, U23.2 (VO), U24.2 (VDD), U25.4 (V3), U25.16 (VCC); also elsewhere on the board
3.7V: C96.2, J3.2, S5.3, S6.1
5V: J1.A4_B9 (VBUS), J1.B4_A9 (VBUS), R79.1, S6.3
+2V: C4.1, R1.2, U4.11 (OUT+); also elsewhere on the board
-2V: C5.2, R4.1, U4.6 (OUT-); also elsewhere on the board
ADC_1: U3.4 (AIN0); also elsewhere on the board
ADC_2: U3.5 (AIN1); also elsewhere on the board
ADC_3: U3.6 (AIN2); also elsewhere on the board
ADC_4: U3.7 (AIN3); also elsewhere on the board
CH340_RX: U24.35 (TXD0/IO1), U25.3 (RXD)
CH340_TX: U24.34 (RXD0/IO3), U25.2 (TXD)
DTR: Q2.3 (C), R80.1, U25.13 (~DTR)
EN: C89.1, Q1.3 (C), R82.2, S7.1, U24.3 (EN)
GND: C1.2, C3.2, C4.2, C5.1, C27.2, C86.2, C87.2, C88.1, C89.2, C90.2, C91.1, C96.1, D1.1 (K), J1.A1_B12 (GND), J1.B1_A12 (GND), J1.S1 (SHIELD), J1.S2 (SHIELD), J1.S3 (SHIELD), J1.S4 (SHIELD), J3.1, L2.2, R2.1, R3.2, S7.2, S8.2, U4.1 (PGOOD), U4.4 (GND), U4.13 (PAD), U23.1 (GND), U24.1 (GND), U24.15 (GND), U24.38 (GND), U24.39 (GND), U25.1 (GND); also elsewhere on the board
GND_ADC: C28.1, L2.1, R26.2, R27.2, U3.3 (GND)
IO0: C90.1, Q2.2 (E), R83.2, S8.1, U24.25 (IO0)
unnamed: D1.2 (A), R79.2
unnamed: Q1.1 (B), R80.2
unnamed: Q2.1 (B), R81.2
unnamed: R26.1, U3.1 (ADDR)
unnamed: R27.1, U3.2 (ALERT/RDY)
unnamed: C2.2, U4.10 (C1+)
unnamed: C2.1, U4.9 (C1-)
unnamed: C3.1, U4.5 (CPOUT)
unnamed: C1.1, S5.2, U4.3 (VIN), U4.8 (EN-), U4.12 (EN+)
unnamed: R1.1, R2.2, U4.2 (FB+)
unnamed: R3.1, R4.2, U4.7 (FB-)
unnamed: C87.1, S6.2, U23.3 (VI)
RTS: Q1.2 (E), R81.1, U25.14 (~RTS)
SCL: R24.2, U3.10 (SCL), U24.8 (IO32); also elsewhere on the board
SDA: R25.2, U3.9 (SDA), U24.9 (IO33); also elsewhere on the board
USB_D+: J1.A6 (DP1), J1.B6 (DP2), U25.5 (UD+)
USB_D-: J1.A7 (DN1), J1.B7 (DN2), U25.6 (UD-)
VDD: C28.2, L1.1, R24.1, R25.1, U3.8 (VDD)
VN: U24.5 (SENSOR_VN)
VP: U24.4 (SENSOR_VP)

Notes on the sheet:
ADC
BOOT RST
CH340C
3.3V LDO
auto-download
+2V -2V DCDC
Type-C
esp32-Wroom-32D

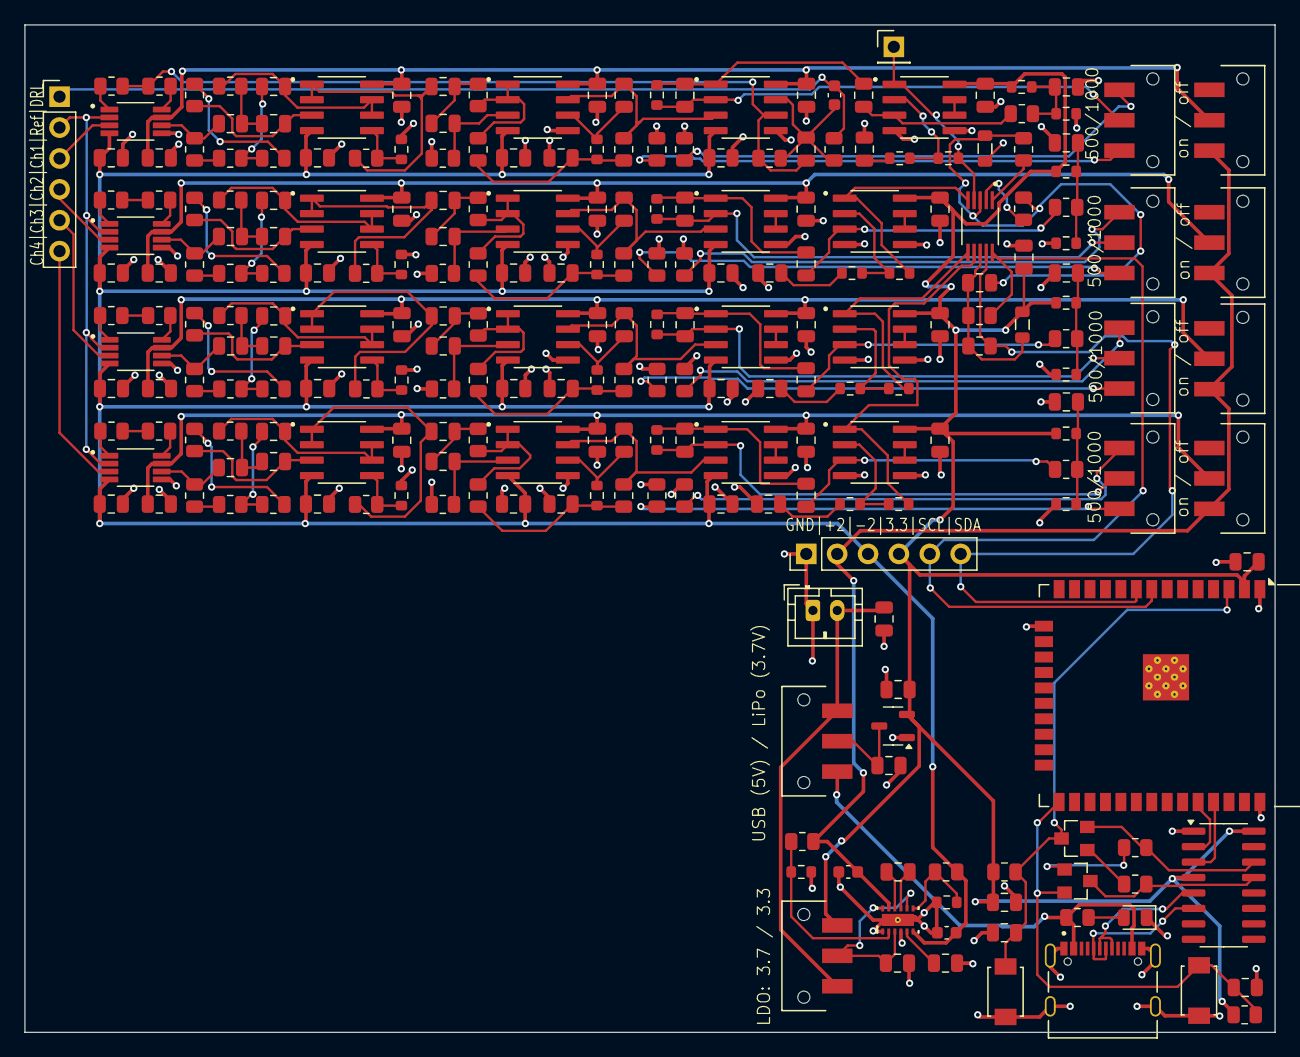
[picture p74: board eeg_4-channel_final.kicad_pcb from above]

Board: 2 copper layers, 102.8 x 82.8 mm, 246 parts (0 on the bottom side), 152 nets.
