XuanqinYu/eegDevice_DTU/Codes/[ESP-IDF] BLE_ULP/esp-idf_code/main/ble_app.c

#include <stdio.h>
#include <stdlib.h>
#include <string.h>
#include "freertos/FreeRTOS.h"
#include "freertos/task.h"
#include "freertos/event_groups.h"
#include "esp_system.h"
#include "esp_log.h"
#include "esp_bt.h"

#include "esp_gap_ble_api.h"
#include "esp_gatts_api.h"
#include "esp_bt_defs.h"
#include "esp_bt_main.h"
#include "esp_gatt_common_api.h"
#include "nvs_flash.h"

#include "esp_sleep.h"

#define TAG "BLE_CFG"
extern uint8_t ads1115_mode;


//设备名称
#define BLE_DEVICE_NAME     "EEG_BLE"


#define ESP_APP_ID                  0x55

#define SVC_IND_ID1      0
#define SVC_IND_ID2      1
#define MAX_PACKET_SIZE  514  // 每次发送最多500字节

//蓝牙模块
enum
{
    //服务1
    SV1_IDX_SVC,

    //特征1
    SV1_CH1_IDX_CHAR,
    SV1_CH1_IDX_CHAR_VAL,
    SV1_CH1_IDX_CHAR_CFG,

    //特征2
    SV1_CH2_IDX_CHAR,
    SV1_CH2_IDX_CHAR_VAL,
    SV1_CH2_IDX_CHAR_CFG,

    SV1_IDX_NB,
};



static const uint16_t GATTS_SERVICE_UUID_TEST       = 0x18FF;   //Service: EEG Data
static const uint16_t GATTS_CHAR_UUID_CH1           = 0x2AFE;   //Chara1: value
static const uint16_t GATTS_CHAR_UUID_CH2           = 0x2A57;   //Chara2: mode setting (digital output)


//主要服务声明UUID 0x2800
static const uint16_t primary_service_uuid         = ESP_GATT_UUID_PRI_SERVICE;

//次要服务声明UUID 0x2801
//static const uint16_t second_service_uuid          = ESP_GATT_UUID_SEC_SERVICE;

//特征声明UUID 0x2803
static const uint16_t character_declaration_uuid   = ESP_GATT_UUID_CHAR_DECLARE;

//特征描述UUID 0x2902
static const uint16_t character_client_config_uuid = ESP_GATT_UUID_CHAR_CLIENT_CONFIG;
//读权限
//static const uint8_t char_prop_read                =  ESP_GATT_CHAR_PROP_BIT_READ;
//写权限
//static const uint8_t char_prop_write               = ESP_GATT_CHAR_PROP_BIT_WRITE;
//读写、通知权限
static const uint8_t char_prop_read_write_notify   = ESP_GATT_CHAR_PROP_BIT_WRITE | ESP_GATT_CHAR_PROP_BIT_READ | ESP_GATT_CHAR_PROP_BIT_NOTIFY;
//读、通知权限
static const uint8_t char_prop_read_notify = ESP_GATT_CHAR_PROP_BIT_READ | ESP_GATT_CHAR_PROP_BIT_NOTIFY;
//特征1客户端特征配置
static uint8_t sv1_ch1_client_cfg[2] = {0x00, 0x00};
//特征2客户端特征配置
static uint8_t sv1_ch2_client_cfg[2]  = {0x00,0x00};


//gatt的访问接口，一个Profile（APP）对应1个
static uint16_t gl_gatts_if = ESP_GATT_IF_NONE;
//连接ID，连接成功后
// static uint16_t gl_conn_id = 0xFFFF;
uint16_t gl_conn_id = 0xFFFF;

//char1的值
static char sv1_char1_value[20] = {0};
//char2的值
static char sv1_char2_value[1] = {0x00};

//att的handle表
uint16_t sv1_handle_table[SV1_IDX_NB];


static uint8_t adv_config_done       = 0;

#define ADV_CONFIG_FLAG             (1 << 0)
#define SCAN_RSP_CONFIG_FLAG        (1 << 1)

//广播参数
static esp_ble_adv_params_t adv_params = {
    .adv_int_min         = 0x20,                //最小广播间隔，单位:0.625ms
    .adv_int_max         = 0x40,                //最大广播间隔，单位:0.625ms
    // .adv_int_min         = 0x400,                //最小广播间隔，单位:0.625ms
    // .adv_int_max         = 0x800,                //最大广播间隔，单位:0.625ms
    .adv_type            = ADV_TYPE_IND,        //广播类型(可连接的非定向广播)
    .own_addr_type       = BLE_ADDR_TYPE_PUBLIC,//使用固定地址广播
    .channel_map         = ADV_CHNL_ALL,        //在37、38、39信道进行广播
    .adv_filter_policy   = ADV_FILTER_ALLOW_SCAN_ANY_CON_ANY,   //广播过滤策略（接收任何scan和任何连接）
};

//gatt描述表
static const esp_gatts_attr_db_t gatt1_db[SV1_IDX_NB] =
{
    //服务声明
    [SV1_IDX_SVC]        =
    {{ESP_GATT_AUTO_RSP}, {ESP_UUID_LEN_16, (uint8_t *)&primary_service_uuid, ESP_GATT_PERM_READ,
      sizeof(uint16_t), sizeof(GATTS_SERVICE_UUID_TEST), (uint8_t *)&GATTS_SERVICE_UUID_TEST}},

    //特征1 EEG data
    //特征声明
    [SV1_CH1_IDX_CHAR]     =
    {{ESP_GATT_AUTO_RSP}, {ESP_UUID_LEN_16, (uint8_t *)&character_declaration_uuid, ESP_GATT_PERM_READ,
      sizeof(uint8_t), sizeof(uint8_t), (uint8_t *)&char_prop_read_notify}},   //特征值1允许读通知
    //特征值
    [SV1_CH1_IDX_CHAR_VAL] =
    {{ESP_GATT_RSP_BY_APP}, {ESP_UUID_LEN_16, (uint8_t *)&GATTS_CHAR_UUID_CH1, ESP_GATT_PERM_READ, 
      sizeof(sv1_char1_value), sizeof(sv1_char1_value), (uint8_t *)sv1_char1_value}},
    //特征描述->客户端特征配置
    [SV1_CH1_IDX_CHAR_CFG]  =
    {{ESP_GATT_AUTO_RSP}, {ESP_UUID_LEN_16, (uint8_t *)&character_client_config_uuid, ESP_GATT_PERM_READ|ESP_GATT_PERM_WRITE,
      sizeof(uint16_t), sizeof(sv1_ch1_client_cfg), (uint8_t *)sv1_ch1_client_cfg}},

    //特征2 setting mode
    //特征声明
    [SV1_CH2_IDX_CHAR]      =
    {{ESP_GATT_AUTO_RSP}, {ESP_UUID_LEN_16, (uint8_t *)&character_declaration_uuid, ESP_GATT_PERM_READ,
      sizeof(uint8_t), sizeof(uint8_t), (uint8_t *)&char_prop_read_write_notify}},  //特征值2允许读写和通知

    //特征值
    [SV1_CH2_IDX_CHAR_VAL]  =
    {{ESP_GATT_RSP_BY_APP}, {ESP_UUID_LEN_16, (uint8_t *)&GATTS_CHAR_UUID_CH2, ESP_GATT_PERM_READ|ESP_GATT_PERM_WRITE,
      sizeof(sv1_char2_value), sizeof(sv1_char2_value), (uint8_t *)sv1_char2_value}},

    //特征描述->客户端特征配置
    [SV1_CH2_IDX_CHAR_CFG]      =
    {{ESP_GATT_AUTO_RSP}, {ESP_UUID_LEN_16, (uint8_t *)&character_client_config_uuid, ESP_GATT_PERM_READ|ESP_GATT_PERM_WRITE,
      sizeof(uint16_t), sizeof(sv1_ch2_client_cfg), (uint8_t *)&sv1_ch2_client_cfg}},

};

static uint8_t adv_service_uuid16[] = {
    /* LSB <--------------------------------------------------------------------------------> MSB */
    //first uuid, 16bit, [12],[13] is the value
    0xfb, 0x34, 0x9b, 0x5f, 0x80, 0x00, 0x00, 0x80, 0x00, 0x10, 0x00, 0x00, GATTS_SERVICE_UUID_TEST&0xff,(GATTS_SERVICE_UUID_TEST>>8)&0xff, 0x00, 0x00,
    //GATTS_SERVICE_UUID_TEST&0xff,(GATTS_SERVICE_UUID_TEST>>8)&0xff,
    //GATTS_SERVICE2_UUID_TEST&0xff,(GATTS_SERVICE2_UUID_TEST>>8)&0xff,
};


// The length of adv data must be less than 31 bytes
//static uint8_t test_manufacturer[TEST_MANUFACTURER_DATA_LEN] =  {0x12, 0x23, 0x45, 0x56};
//adv data广播数据
static esp_ble_adv_data_t adv_data = {
    .set_scan_rsp = false,      //此广播数据是否扫描回复
    .include_name = true,       //是否包含名字
    .include_txpower = false,   //是否包含发射功率
    .min_interval = 0x0006, //最小连接间隔 单位1.25ms
    .max_interval = 0x0010, //最大连接间隔 单位1.25ms
    .appearance = 0x00,     //apperance
    .manufacturer_len = 0, //厂商信息长度
    .p_manufacturer_data =  NULL, //厂商信息
    .service_data_len = 0,      //服务数据长度
    .p_service_data = NULL,     //服务数据
    .service_uuid_len = sizeof(adv_service_uuid16),    //服务UUID长度
    .p_service_uuid = adv_service_uuid16,              //服务UUID
    .flag = (ESP_BLE_ADV_FLAG_GEN_DISC | ESP_BLE_ADV_FLAG_BREDR_NOT_SPT),//普通发现模式|不支持EDR经典蓝牙
};
//扫描回复数据，用于主机在主动扫描时，向设备发起扫描请求，设备需要回复的内容
static esp_ble_adv_data_t scan_rsp_data = {
    .set_scan_rsp = true,
    .include_name = true,
    .include_txpower = true,
    //.min_interval = 0x0006,
    //.max_interval = 0x0010,
    .appearance = 0x00,
    .manufacturer_len = 0, //TEST_MANUFACTURER_DATA_LEN,
    .p_manufacturer_data =  NULL, //&test_manufacturer[0],
    .service_data_len = 0,
    .p_service_data = NULL,
    .service_uuid_len = sizeof(adv_service_uuid16),
    .p_service_uuid = adv_service_uuid16,
    .flag = (ESP_BLE_ADV_FLAG_GEN_DISC | ESP_BLE_ADV_FLAG_BREDR_NOT_SPT),
};

/**
 * gatt事件回调函数
 * @param event 事件ID
 * @param gatts_if gatt接口，一个profile对应一个
 * @param param 事件参数
 * @return 无
 */
static void gatts_profile_event_handler(esp_gatts_cb_event_t event, esp_gatt_if_t gatts_if, esp_ble_gatts_cb_param_t *param)
{
    switch (event) {
        case ESP_GATTS_REG_EVT: //可以认为是一个Profile GATTS启动时会进入此事件
        {
            //设置广播名称
            esp_err_t set_dev_name_ret = esp_ble_gap_set_device_name(BLE_DEVICE_NAME);
            if (set_dev_name_ret){
                ESP_LOGE(TAG, "set device name failed, error code = %x", set_dev_name_ret);
            }
            //设置广播数据
            esp_err_t ret = esp_ble_gap_config_adv_data(&adv_data);
            if (ret){
                ESP_LOGE(TAG, "config adv data failed, error code = %x", ret);
            }
            adv_config_done |= ADV_CONFIG_FLAG;
            //设置扫描回复参数
            ret = esp_ble_gap_config_adv_data(&scan_rsp_data);
            if (ret){
                ESP_LOGE(TAG, "config scan response data failed, error code = %x", ret);
            }
            adv_config_done |= SCAN_RSP_CONFIG_FLAG;      
            //注册attr表1
            esp_err_t create_attr_ret = esp_ble_gatts_create_attr_tab(gatt1_db, gatts_if, SV1_IDX_NB, SVC_IND_ID1);
            if (create_attr_ret){
                ESP_LOGE(TAG, "create attr1 table failed, error code = %x", create_attr_ret);
            }
            if(param->reg.status == ESP_GATT_OK)
            {
                gl_gatts_if = gatts_if;
                //gl_conn_id = param->connect.conn_id;
            }
        }
       	    break;
        case ESP_GATTS_READ_EVT:    //收到客户端的读取事件
        {
            ESP_LOGI(TAG, "ESP_GATTS_READ_EVT");
            esp_gatt_rsp_t rsp;
            memset(&rsp, 0, sizeof(esp_gatt_rsp_t));
            rsp.attr_value.handle = param->read.handle;
            if(sv1_handle_table[SV1_CH1_IDX_CHAR_VAL] == param->read.handle) // EEG data
            {
                rsp.attr_value.len = sizeof(sv1_char1_value);
                memcpy(rsp.attr_value.value,sv1_char1_value,sizeof(sv1_char1_value));
            }
            if(sv1_handle_table[SV1_CH2_IDX_CHAR_VAL] == param->read.handle) // settig mode
            {
                rsp.attr_value.len = sizeof(sv1_char2_value);
                memcpy(rsp.attr_value.value,sv1_char2_value,sizeof(sv1_char2_value));
            }
            esp_ble_gatts_send_response(gatts_if, param->read.conn_id, param->read.trans_id,ESP_GATT_OK, &rsp);
       	    break;
        }
        case ESP_GATTS_WRITE_EVT:   //收到客户端的写事件
            if (!param->write.is_prep){
                // the data length of gattc write  must be less than GATTS_DEMO_CHAR_VAL_LEN_MAX.
                ESP_LOGI(TAG, "GATT_WRITE_EVT, handle = %d, value len = %d, value :", param->write.handle, param->write.len);
                esp_log_buffer_hex(TAG, param->write.value, param->write.len);
                if(param->write.handle == sv1_handle_table[SV1_CH1_IDX_CHAR_CFG])    //特征1客户端特征配置
                {
                    sv1_ch1_client_cfg[0] = param->write.value[0];
                    sv1_ch1_client_cfg[1] = param->write.value[1];
                }
                else if(param->write.handle == sv1_handle_table[SV1_CH2_IDX_CHAR_CFG])   //特征2客户端特征配置
                {
                    sv1_ch2_client_cfg[0] = param->write.value[0];
                    sv1_ch2_client_cfg[1] = param->write.value[1];
                }
                else if(param->write.handle == sv1_handle_table[SV1_CH2_IDX_CHAR_VAL])   //特征2的值
                {
                    sv1_char2_value[0] = param->write.value[0];
                    //sv1_char2_value[1] = param->write.value[1];
                    ads1115_mode = sv1_char2_value[0];
                    // ESP_LOGI(TAG, "channel number: %d", sv1_char2_value[0]);    //收到命令，输出收到的值
                }

                if (param->write.need_rsp){
                    esp_ble_gatts_send_response(gatts_if, param->write.conn_id, param->write.trans_id, ESP_GATT_OK, NULL);
                }
            }
      	    break;
        case ESP_GATTS_EXEC_WRITE_EVT:
            // the length of gattc prepare write data must be less than GATTS_DEMO_CHAR_VAL_LEN_MAX.
            ESP_LOGI(TAG, "ESP_GATTS_EXEC_WRITE_EVT");
            //example_exec_write_event_env(&prepare_write_env, param);
            break;
        case ESP_GATTS_MTU_EVT:
            ESP_LOGI(TAG, "ESP_GATTS_MTU_EVT, MTU %d", param->mtu.mtu);
            break;
        case ESP_GATTS_CONF_EVT:
            ESP_LOGI(TAG, "ESP_GATTS_CONF_EVT, status = %d, attr_handle %d", param->conf.status, param->conf.handle);
            break;
        case ESP_GATTS_START_EVT:
            ESP_LOGI(TAG, "SERVICE_START_EVT, status %d, service_handle %d", param->start.status, param->start.service_handle);
            break;
        case ESP_GATTS_CONNECT_EVT:     //收到连接事件
            ESP_LOGI(TAG, "ESP_GATTS_CONNECT_EVT, conn_id = %d", param->connect.conn_id);
            esp_log_buffer_hex(TAG, param->connect.remote_bda, 6);
            esp_ble_conn_update_params_t conn_params = {0};
            
            /* For the iOS system, please refer to Apple official documents about the BLE connection parameters restrictions. */
            // conn_params.latency = 30;       //从机延迟
            // conn_params.max_int = 0xC80;    // 最大连接间隔 = 0x20*1.25ms = 40ms
            // conn_params.min_int = 0x640;    // 最小连接间隔 = 0x10*1.25ms = 20ms
            // conn_params.timeout = 6000;    // 监控超时 = 400*10ms = 4000ms
            conn_params.latency = 0;       //从机延迟
            conn_params.max_int = 0x20;    // 最大连接间隔 = 0x20*1.25ms = 40ms
            conn_params.min_int = 0x10;    // 最小连接间隔 = 0x10*1.25ms = 20ms
            conn_params.timeout = 400;    // 监控超时 = 400*10ms = 4000ms
            //start sent the update connection parameters to the peer device.
            memcpy(conn_params.bda, param->connect.remote_bda, sizeof(esp_bd_addr_t));
            esp_ble_gap_update_conn_params(&conn_params);
            gl_conn_id = param->connect.conn_id;

            // 停止BLE广播，防止高功耗
            // esp_ble_tx_power_set(ESP_BLE_PWR_TYPE_ADV, ESP_PWR_LVL_N12); // 降低广播功率
            // esp_ble_tx_power_set(ESP_BLE_PWR_TYPE_DEFAULT, ESP_PWR_LVL_N12); // 降低默认功率
            esp_err_t ret = esp_ble_gap_stop_advertising();
            ESP_LOGI(TAG, "Stop advertising result: %s", (ret == ESP_OK) ? "Success" : "Failed");
            // ads1115_mode = 1;

            break;
        case ESP_GATTS_DISCONNECT_EVT:  //收到断开连接事件
            ESP_LOGI(TAG, "ESP_GATTS_DISCONNECT_EVT, reason = 0x%x", param->disconnect.reason);
            esp_ble_gap_start_advertising(&adv_params);
            gl_conn_id = 0xFFFF;
            break;
        case ESP_GATTS_CREAT_ATTR_TAB_EVT: //注册ATTR表成功事件
            if (param->add_attr_tab.status != ESP_GATT_OK){
                    ESP_LOGE(TAG, "create attribute table failed, svc id = %d,error code=0x%x",param->add_attr_tab.svc_inst_id, param->add_attr_tab.status);
                }
            if(param->add_attr_tab.svc_inst_id == SVC_IND_ID1)
            {
                
                if (param->add_attr_tab.num_handle != SV1_IDX_NB){
                    ESP_LOGE(TAG, "create attribute table abnormally, num_handle (%d) \
                            doesn't equal to NETCFG_IDX_NB(%d)", param->add_attr_tab.num_handle, SV1_IDX_NB);
                }
                else {
                    ESP_LOGI(TAG, "create attribute table successfully, the number handle = %d\n",param->add_attr_tab.num_handle);
                    memcpy(sv1_handle_table, param->add_attr_tab.handles, sizeof(sv1_handle_table));
                    esp_ble_gatts_start_service(sv1_handle_table[SV1_IDX_SVC]);
                }
                
            }
            break;
        case ESP_GATTS_STOP_EVT:
        case ESP_GATTS_OPEN_EVT:
        case ESP_GATTS_CANCEL_OPEN_EVT:
        case ESP_GATTS_CLOSE_EVT:
        case ESP_GATTS_LISTEN_EVT:
        case ESP_GATTS_CONGEST_EVT:
        case ESP_GATTS_UNREG_EVT:
        case ESP_GATTS_DELETE_EVT:
        default:
            break;
    }
}

/**
 * gap事件回调函数
 * @param event 事件ID
 * @param param 事件参数
 * @return 无
 */
static void gap_event_handler(esp_gap_ble_cb_event_t event, esp_ble_gap_cb_param_t *param)
{
    switch (event) {
        case ESP_GAP_BLE_ADV_DATA_SET_COMPLETE_EVT:     //设置广播数据成功事件
            adv_config_done &= (~ADV_CONFIG_FLAG);
            if (adv_config_done == 0){
                esp_ble_gap_start_advertising(&adv_params);
            }
            break;
        case ESP_GAP_BLE_SCAN_RSP_DATA_SET_COMPLETE_EVT:    //设置扫描回复数据成功事件
            adv_config_done &= (~SCAN_RSP_CONFIG_FLAG);
            if (adv_config_done == 0){
                esp_ble_gap_start_advertising(&adv_params);
            }
            break;
        case ESP_GAP_BLE_ADV_START_COMPLETE_EVT:            //启动广播成功事件
            /* advertising start complete event to indicate advertising start successfully or failed */
            if (param->adv_start_cmpl.status != ESP_BT_STATUS_SUCCESS) {
                ESP_LOGE(TAG, "advertising start failed");
            }else{
                ESP_LOGI(TAG, "advertising start successfully");
            }
            break;
        case ESP_GAP_BLE_ADV_STOP_COMPLETE_EVT:             //停止广播成功事件
            if (param->adv_stop_cmpl.status != ESP_BT_STATUS_SUCCESS) {
                ESP_LOGE(TAG, "Advertising stop failed");
            }
            else {
                ESP_LOGI(TAG, "Stop adv successfully\n");
            }
            break;
        case ESP_GAP_BLE_UPDATE_CONN_PARAMS_EVT:        //更新连接参数成功事件
            ESP_LOGI(TAG, "update connection params status = %d, min_int = %d, max_int = %d,conn_int = %d,latency = %d, timeout = %d",
                  param->update_conn_params.status,
                  param->update_conn_params.min_int,
                  param->update_conn_params.max_int,
                  param->update_conn_params.conn_int,
                  param->update_conn_params.latency,
                  param->update_conn_params.timeout);
            break;
        // case ESP_GATTS_CONNECT_EVT:
        //     // BLE连接后禁止深度睡眠
        //     spinlock_acquire(light_sleep_lock);
        //     break;
        // case ESP_GATTS_DISCONNECT_EVT:
        //     // 断开后恢复低功耗
        //     spinlock_release(light_sleep_lock);
        //     break;
    
        default:
            break;
    }
}



/**
 * 初始化并启动蓝牙BLE
 * @param 无
 * @return 是否成功
 */
esp_err_t ble_cfg_net_init(void)
{
    esp_err_t ret;
    ESP_ERROR_CHECK(esp_bt_controller_mem_release(ESP_BT_MODE_CLASSIC_BT));

    esp_bt_controller_config_t bt_cfg = BT_CONTROLLER_INIT_CONFIG_DEFAULT();
    bt_cfg.ble_max_conn  = 1;       // 仅保留1个活动连接
    ESP_ERROR_CHECK(esp_bt_controller_init(&bt_cfg));
    ESP_ERROR_CHECK(esp_bt_controller_enable(ESP_BT_MODE_BLE));
    esp_bluedroid_config_t bluedroid_cfg = BT_BLUEDROID_INIT_CONFIG_DEFAULT();
    ESP_ERROR_CHECK(esp_bluedroid_init_with_cfg(&bluedroid_cfg));
    ESP_ERROR_CHECK(esp_bluedroid_enable());
    ESP_ERROR_CHECK(esp_ble_gatts_register_callback(gatts_profile_event_handler));
    ESP_ERROR_CHECK(esp_ble_gap_register_callback(gap_event_handler));
    ESP_ERROR_CHECK(esp_ble_gatts_app_register(ESP_APP_ID));    //一个APP对应一份Profile
    ESP_ERROR_CHECK(esp_ble_gatt_set_local_mtu(517));
    // ESP_ERROR_CHECK(esp_ble_gattc_send_mtu_req(gatts_if, 400));
    esp_ble_scan_params_t scan_params = {
        .scan_type = BLE_SCAN_TYPE_PASSIVE,
        .own_addr_type = BLE_ADDR_TYPE_PUBLIC,
        .scan_filter_policy = BLE_SCAN_FILTER_ALLOW_ALL,
        .scan_interval = 0x100,     // 扫描间隔
        .scan_window = 0x50         // 扫描窗口
    };
    ESP_ERROR_CHECK(esp_ble_gap_set_scan_params(&scan_params));
    esp_ble_tx_power_set(ESP_BLE_PWR_TYPE_DEFAULT, ESP_PWR_LVL_N12);  // 全局默认功率
    esp_ble_tx_power_set(ESP_BLE_PWR_TYPE_ADV, ESP_PWR_LVL_N12);       // 广播功率
    esp_ble_tx_power_set(ESP_BLE_PWR_TYPE_SCAN, ESP_PWR_LVL_N9);       // 连接功率
    
    return ESP_OK;
}



// /**
//  * 设置特征1的值
//  * @param value 值
//  * @return 无
//  */
// void ble_set_ch1_value(uint16_t value)
// {
//     sv1_char2_value[0] = value&0xff;
//     sv1_char2_value[1] = value>>8;
//     //判断连接是否有效，以及客户端特征配置是否不为0
//     if(gl_conn_id != 0xFFFF && (sv1_ch1_client_cfg[0] | sv1_ch1_client_cfg[1]))
//     {
//         esp_ble_gatts_set_attr_value(sv1_handle_table[SV1_CH1_IDX_CHAR_VAL], 2, (const uint8_t*)&sv1_char2_value);
//         esp_ble_gatts_send_indicate(gl_gatts_if, gl_conn_id,sv1_handle_table[SV1_CH1_IDX_CHAR_VAL], 2, (uint8_t*)&sv1_char2_value, false);
//     }
// }

void ble_send_data(uint8_t *data, uint16_t length)
{
    if(gl_conn_id != 0xFFFF && (sv1_ch1_client_cfg[0] | sv1_ch1_client_cfg[1]))
    {
        esp_ble_gatts_set_attr_value(sv1_handle_table[SV1_CH1_IDX_CHAR_VAL], length, data);
        esp_ble_gatts_send_indicate(gl_gatts_if, gl_conn_id, sv1_handle_table[SV1_CH1_IDX_CHAR_VAL], length, data, false);
    }
}

// 每次 MAX_PACKET_SIZE 字节
void ble_set_ch1_value_large(uint8_t *data, uint16_t total_length)
{
    uint16_t offset = 0;
    while (offset < total_length)
    {
        uint16_t chunk_size = (total_length - offset > MAX_PACKET_SIZE) ? MAX_PACKET_SIZE : (total_length - offset);
        ble_send_data(data + offset, chunk_size);
        offset += chunk_size;
        vTaskDelay(pdMS_TO_TICKS(20)); // 避免数据过快导致丢失
    }
}

/**
 * 设置特征2的值
 * @param value 值
 * @return 无
 */
void ble_set_ch2_value(uint16_t value)
{
    sv1_char2_value[0] = value&0xff;
    //sv2_char2_value[1] = value>>8;
    //判断连接是否有效，以及客户端特征配置是否不为0
    if(gl_conn_id != 0xFFFF && (sv1_ch2_client_cfg[0] | sv1_ch2_client_cfg[1]))
    {
        esp_ble_gatts_set_attr_value(sv1_handle_table[SV1_CH2_IDX_CHAR_VAL], 2, (const uint8_t*)&sv1_char2_value);
        esp_ble_gatts_send_indicate(gl_gatts_if, gl_conn_id,sv1_handle_table[SV1_CH2_IDX_CHAR_VAL], 2, (uint8_t*)&sv1_char2_value, false);
    }
}
