XuanqinYu/eegDevice_DTU/(commit log)

2025-03-30 工程文件
    [BOM-eeg_4-channel_final.csv, Channel3_4.kicad_sch, Power_MCU_ADC.kicad_sch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]
2025-04-14 editted at 2025/4/14
    [BOM-eeg_4-channel_final.csv, BOM-eeg_diy.csv, Channel3_4.kicad_sch, Power_MCU_ADC.kicad_sch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]
